skyrimax/Autobar/Document Remise/Rapport final/Image/Distributeur_Beaumont.jpg

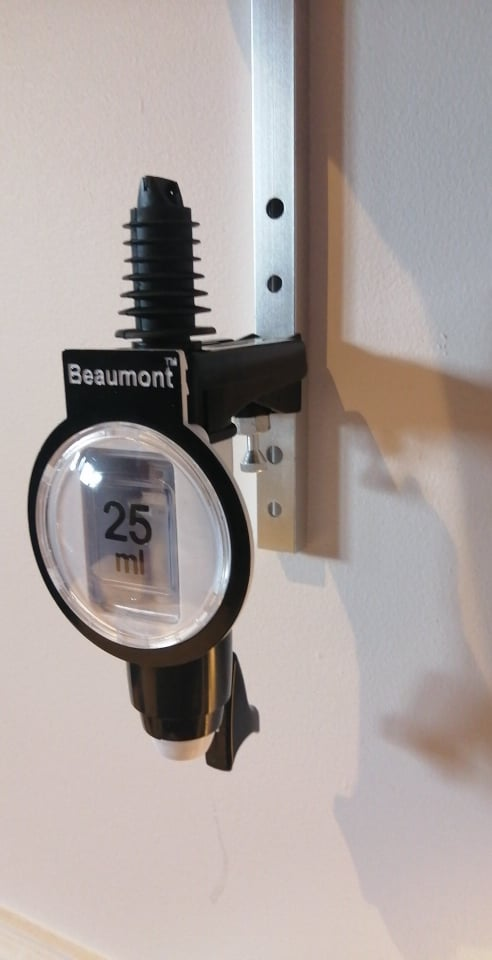
Document Remise/Rapport final/Image/Distributeur_Beaumont.jpg
