skyrimax/Autobar/Document Remise/Rapport etape/Axe_lineaire_seul_Nema17.JPG

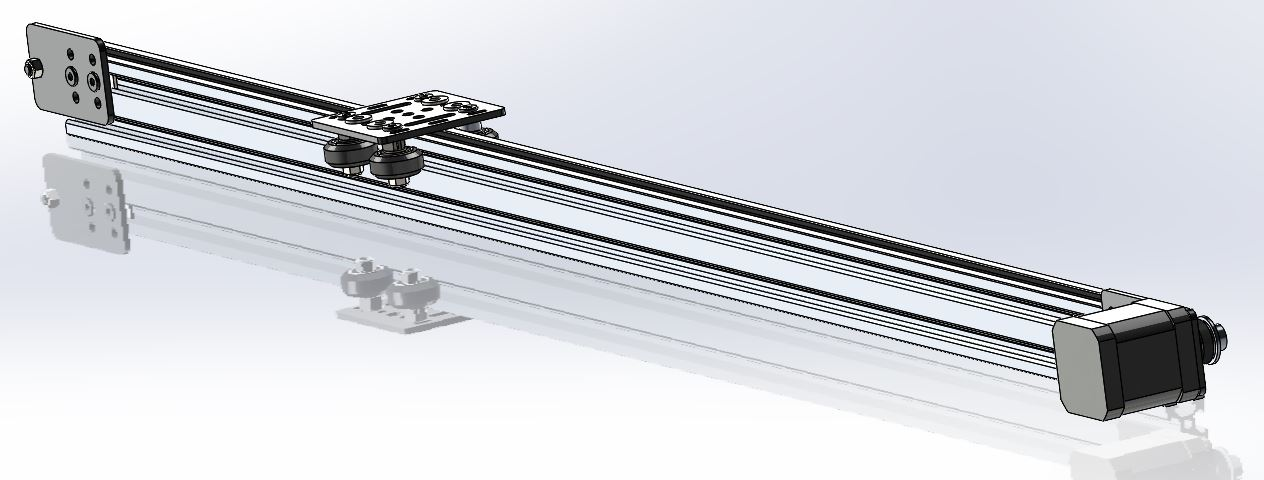
Document Remise/Rapport etape/Axe_lineaire_seul_Nema17.JPG
