skyrimax/Autobar/Choix de concept/Définition besoin.docx

Choix de microcontrôleur (électronique logique)

https://all3dp.com/fr/1/single-board-computer-raspberry-pi-alternative/

CanOpen, i2c, pwm, in/out, internet, écran tactile?

- Internet (wifi)
- 1 moteur encodeur (robotshop) avec drive (can, i2c, pwm) versaplanetary
- LED
- Écran tactile
- Actuateur (activation distributeur)
