skyrimax/Autobar/Document Remise/Rapport etape/Matrice_Final.pdf

Esthétique | Coût | Simplicité conception | Aisance de maintenance | Expérience utilisateur | Fonctionnalités | Total
Concept | 14% | 10% | 24% | 18% | 20% | 14% | 100%
1 | 70% | 90% | 90% | 90% | 30% | 60% | 71%
2 | 80% | 85% | 90% | 85% | 35% | 60% | 72%
3 | 85% | 70% | 80% | 70% | 70% | 80% | 76%
4 | 80% | 50% | 65% | 60% | 70% | 85% | 69%
5 | 60% | 65% | 80% | 80% | 30% | 65% | 63%
6 | 90% | 40% | 60% | 55% | 90% | 70% | 69%

# Matrice de décision finale
