skyrimax/Autobar/Document Remise/Affiche/Affiche.pdf

## AutoBar : Système automatisé de distribution de boisson alcoolisée

Inconvénients :
- Limité pour le nombre de bouteilles
- Exécution d’une commande à la fois
- Difficilement modulable

Avantages :
- L’interface utilisateur améliore l’expérience client
- Base de données assure la cohérence des données
- Réduction du nombre d’équipements à contrôler

## 3. Avantages/Inconvénients

Inconvénients :
- Limité pour le nombre de bouteilles
- Exécution d’une commande à la fois
- Difficilement modulable

Avantages :
- L’interface utilisateur améliore l’expérience client
- Base de données assure la cohérence des données
- Réduction du nombre d’équipements à contrôler

## 3. Avantages/Inconvénients

Inconvénients :
- Limité pour le nombre de bouteilles
- Exécution d’une commande à la fois
- Difficilement modulable

Avantages :
- L’interface utilisateur améliore l’expérience client
- Base de données assure la cohérence des données
- Réduction du nombre d’équipements à contrôler

## 3. Avantages/Inconvénients

Présenté par : Hugo Beaulieu Blanchette, Frédéric Grondines, Jean-Philippe Lozeau et Maxime Royal

Il s’agit d’automatiser un service de distribution de boisson alcoolisée et non-alcoolisée pour une utilisation personnelle ou lors de petits évènements.

Objectifs :
- Simplicité de conception
- Expérience utilisateur mise de l’avant
- Interface utilisateur
- Historique des données

## 1. Problématique

Il s’agit d’automatiser un service de distribution de boisson alcoolisée et non-alcoolisée pour une utilisation personnelle ou lors de petits évènements.

Objectifs :
- Simplicité de conception
- Expérience utilisateur mise de l’avant
- Interface utilisateur
- Historique des données

## 1. Problématique

Il s’agit d’automatiser un service de distribution de boisson alcoolisée et non-alcoolisée pour une utilisation personnelle ou lors de petits évènements.

Objectifs :
- Simplicité de conception
- Expérience utilisateur mise de l’avant
- Interface utilisateur
- Historique des données
1. | Problématique | 18

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

Objectifs :
- Simplicité de conception
- Expérience utilisateur mise de l’avant
- Interface utilisateur
- Historique des données
1. | Problématique | 18 | 2. | Solution

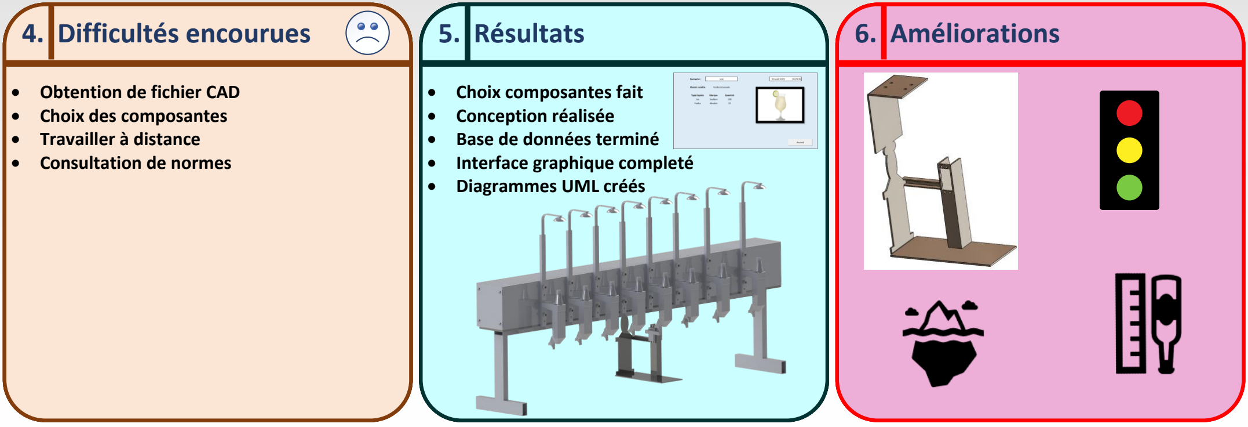
[picture p25: figure]
6. Améliorations; • Choix composantes fait • Conception réalisée • Base de données terminé • Interface graphique completé • Diagrammes UML créés; 5. Résultats; • Obtention de fichier CAD • Choix des composantes • Travailler à distance • Consultation de normes; 4. Difficultés encourues
