skyrimax/Autobar/Document Remise/Affiche/Affiche_Example.pdf

`

# Aero-Planning : outil de gestion de maintenance d’une flotte d’aéronefs

Projet de fin d’études présenté par | , finissante en génie

# Abstrait

- Inspection régulière
- Défaillance
- AD / SB

# Problématique

- Les écoles de pilotage
possèdent beaucoup d’appareils nécessitant un suivi rigoureux
- Liste d’un bon nombre d’items à surveiller
- Actuellement : utilisation d’une liste Excel
- Pas de traçabilité des mises à jour
- Beaucoup d’impression inutile
- Difficilement accessible (un seul à la fois)

# Solution

Les objectifs de ce projet sont de :
- Gérer la cédule de maintenance et les éléments d’entretien des aéronefs ;
- Effectuer le suivi des heures d’opération ;
- Produire des rapports facilitant des audits avec Transport Canada et indiquant les prochaines tâches à suivre sur la flotte.

# Méthodes de travail

# Problèmes encourus

- Disponibilité du programmeur
- Disponibilité du client
- Gestion du temps

# Résultats

# Conclusions

- Le client voulait un outil pour effectuer le suivi des heures d’opération de chaque appareil : un outil flexible, visuel, accessible et facile à utiliser
- Le travail en PME est différent du travail en grande entreprise
- L’outil est encore à la phase de tests et bientôt prêt à être dévoilé au client
- Notre objectif futur est de déployer l’outil chez d’autres exploitants d’aéronefs au Québec

États

Tout est beau

Actions dans les
tolérances

Actions requises
immédiatement

Aéronef

Cédule de
maintenance

Heures d’opération

- En aéronautique, il est
essentiel de garder une
traçabilité sur tout
- Il s’agit d’un domaine stricte et très réglementé, axé sur la sécurité
Web | iPhone | Backup | Plusieurs utilisateurs
Besoins
du client
- Moteur(s)
- Instruments
- Fuselage
- Hélice(s)
- Gouvernes
- Autres items

Outils informatique

Serveur web

Base de données

Savoir pratique

Réglementation
de l’aviation
canadien

Grille de
maintenance

Gestion de projet

Discussion
intantanée

Assignation et
suivi des tâches

Framework

Language de
programmation

Contrôle de
version

Système
d’exploitation

Méthodologie scrum

Méthodologie agile

Prototype

- Confidentialité du client
- Réglementation complexe
à ne pas négliger
