skyrimax/Autobar/Document Remise/machine_rendu.JPG

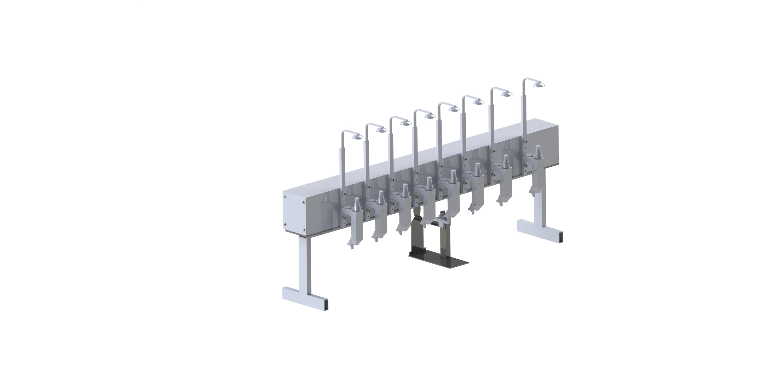
Document Remise/machine_rendu.JPG
