skyrimax/Autobar/Document Remise/Rapport etape/Axe_lineaire_ass.JPG

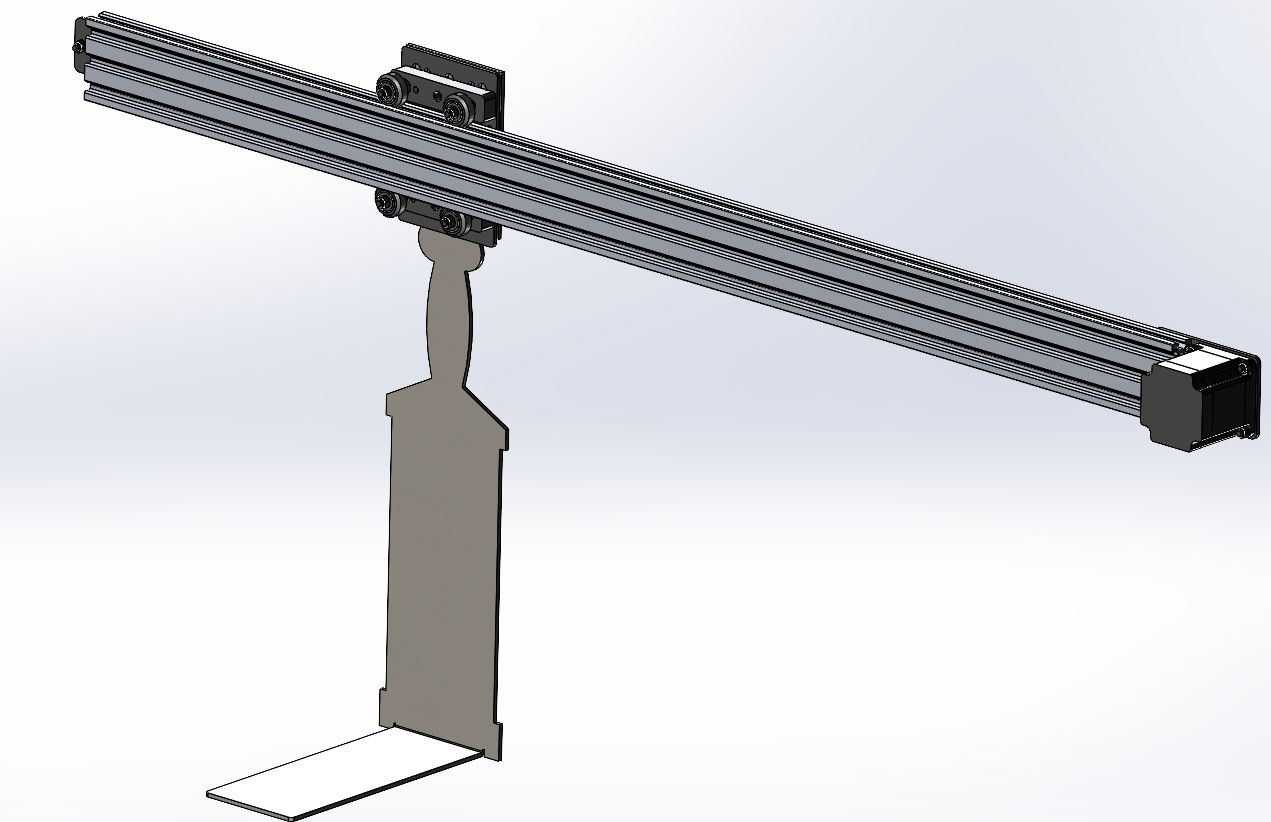
Document Remise/Rapport etape/Axe_lineaire_ass.JPG
