skyrimax/Autobar/Document Remise/Rapport etape/Axe_lineaire_seul.JPG

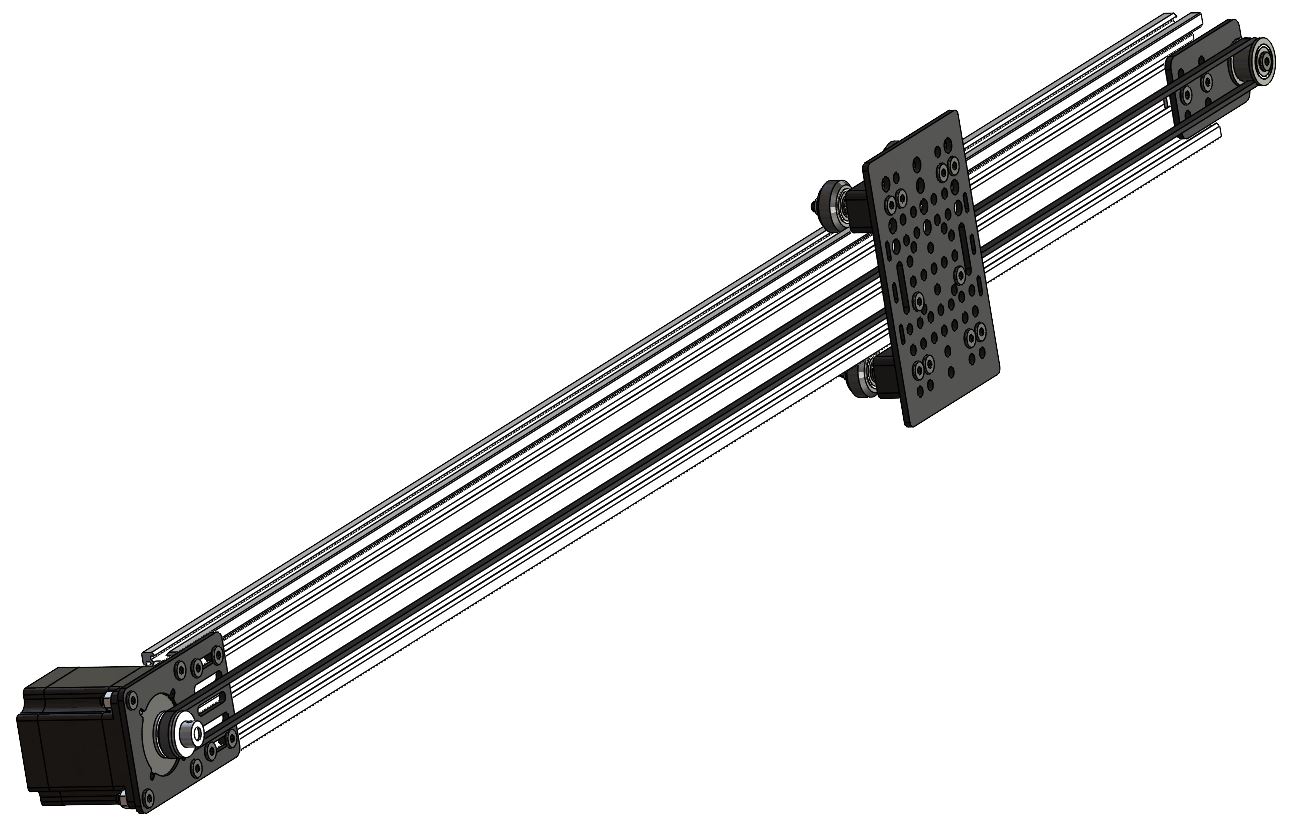
Document Remise/Rapport etape/Axe_lineaire_seul.JPG
