skyrimax/Autobar/Document Remise/Rendu_Machine.png

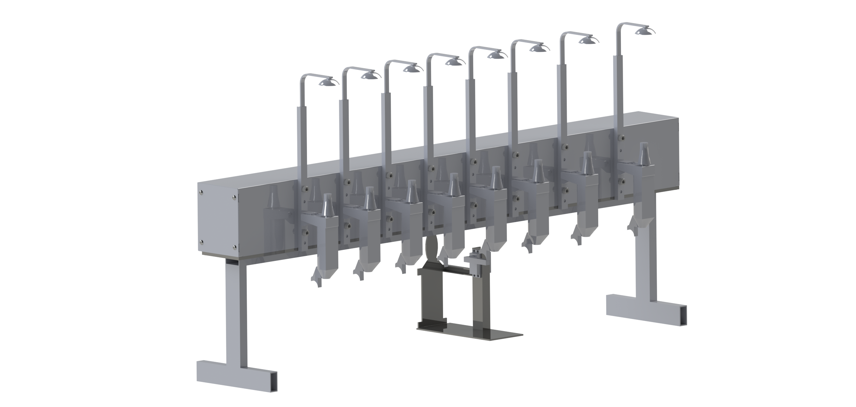
Document Remise/Rendu_Machine.png
