skyrimax/Autobar/Choix de concept/Différents choix.xlsx

Sheet: Association
 |  | Association des différents mécanismes
Impossible | Difficile | Contenant pour distribution |  |  | Disposition bouteille |  |  | Mécanisme de distribution |  |  | Mécanisme de mouvement |  |  | Récipient liquide |  |  |  | Lecture du volume
Faisable | Bon | Bouteille d'origine | Contenant sur mesure | Mixte | En ligne | En cercle | En étage? | Pompe péristaltique | Connecteur universel | Connecteur magnétique | Fixe | Convoyeur | Bouteille en mouvement | Verre plastique standard | Verre custom | Verre spécialisée | Contenant fixe | Lecteur de pression | Mécanisme présent | Capteur numérique | Flotteur | Capteur capacitif
Contenant pour distribution | Bouteille d'origine
 | Contenant sur mesure
 | Mixte
Disposition bouteille | En ligne
 | En cercle
 | En étage?
Mécanisme de distribution | Pompe péristaltique
 | Connecteur universel
 | Connecteur magnétique
Mécanisme de mouvement | Fixe
 | Convoyeur
 | Bouteille en mouvement
Récipient liquide | Verre plastique standard
 | Verre custom
 | Verre spécialisée
 | Contenant fixe
Lecture du volume | Lecteur de pression
 | Mécanisme présent
 | Capteur numérique
 | Flotteur
 | Capteur capacitif

Sheet: Matrice de décision partiel
 |  |  | Matrice de décision partielle
 |  |  | Esthétique | Coût | Simplicité | Fonctionnalité | Synergie | Total | Total avec poids
 | Poids (%) |  | 10% | 15% | 30% | 25% | 20% | 100%
Contenant pour distribution | 15% | Bouteille d'origine | 100% | 100% | 85% | 90% | 65% | 86.0% | 12.9%
 |  | Contenant sur mesure | 50% | 60% | 60% | 70% | 85% | 66.5% | 10.0%
 |  | Mixte | 75% | 70% | 50% | 65% | 70% | 63.2% | 9.5%
Disposition bouteille | 15% | En ligne | 70% | 100% | 90% | 80% | 90% | 87.0% | 13.1%
 |  | En cercle | 95% | 80% | 75% | 60% | 80% | 75.0% | 11.2%
 |  | En étage? |  |  |  |  |  | 0.0% | 0.0%
Mécanisme de distribution | 25% | Pompe péristaltique | 60% | 70% | 85% | 90% | 75% | 79.5% | 19.9%
 |  | Connecteur universel | 90% | 100% | 95% | 75% | 65% | 84.2% | 21.1%
 |  | Connecteur magnétique | 70% | 20% | 10% | 95% | 35% | 43.8% | 10.9%
Mécanisme de mouvement | 30% | Fixe | 30% | 100% | 100% | 40% | 90% | 76.0% | 22.8%
 |  | Convoyeur | 70% | 85% | 85% | 80% | 80% | 81.3% | 24.4%
 |  | Bouteille en mouvement | 90% | 70% | 65% | 85% | 65% | 73.2% | 22.0%
Récipient liquide | 10% | Verre plastique standard | 20% | 100% | 90% | 60% | 80% | 75.0% | 7.5%
 |  | Verre custom | 50% | 60% | 80% | 70% | 100% | 75.5% | 7.5%
 |  | Verre spécialisée | 100% | 20% | 40% | 60% | 70% | 54.0% | 5.4%
 |  | Contenant fixe | 40% | 80% | 70% | 80% | 100% | 77.0% | 7.7%
Lecture du volume | 5% | Lecteur de pression | 50% | 60% | 60% | 40% | 60% | 54.0% | 2.7%
 |  | Mécanisme présent | 100% | 100% | 100% | 70% | 95% | 91.5% | 4.6%
 |  | Capteur numérique | 85% | 50% | 40% | 80% | 65% | 61.0% | 3.1%
 |  | Flotteur | 60% | 90% | 70% | 70% | 70% | 72.0% | 3.6%
 |  | Capteur capacitif | 90% | 60% | 50% | 85% | 40% | 62.3% | 3.1%
Total | 100%

Sheet: Concepts
 |  | Concepts
 |  | Concept #1 | Concept #2 | Concept #3 | Concept #4 | Concept #5 | Concept #6
Contenant pour distribution | Bouteille d'origine | x | x | x |  |  | x
 | Contenant sur mesure |  |  |  | x | x
 | Mixte
Disposition bouteille | En ligne | x |  | x | x | x
 | En cercle |  | x |  |  |  | x
 | En étage?
Mécanisme de distribution | Pompe péristaltique |  |  |  | x
 | Connecteur universel | x | x | x |  | x | x
 | Connecteur magnétique
Mécanisme de mouvement | Fixe | x | x |  |  | x
 | Convoyeur |  |  | x | x
 | Bouteille en mouvement |  |  |  |  |  | x
Récipient liquide | Verre plastique standard | x | x | x |  | x | x
 | Verre custom | x | x | x |  |  | x
 | Verre spécialisée | x | x | x |  |  | x
 | Contenant fixe | x | x | x | x
Lecture du volume | Lecteur de pression
 | Mécanisme présent | x | x | x | x |  | x
 | Capteur numérique
 | Flotteur |  |  |  |  | x
 | Capteur capacitif

Sheet: Matrice de décision concept
 | Matrice de décision finale
 | Esthétique | Coût | Simplicité conception | Aisance de maintenance | Expérience utilisateur | Fonctionnalités | Total
Concept | 14.28571429% | 9.523809524% | 23.80952381% | 17.85714286% | 20.23809524% | 14.28571429% | 100%
1 | 70% | 90% | 90% | 90% | 30% | 60% | 70.71428571%
2 | 80% | 85% | 90% | 85% | 35% | 60% | 71.78571429%
3 | 85% | 70% | 80% | 70% | 70% | 80% | 75.95238095%
4 | 80% | 50% | 65% | 60% | 70% | 85% | 68.69047619%
5 | 60% | 65% | 80% | 80% | 30% | 65% | 63.45238095%
6 | 90% | 40% | 60% | 55% | 90% | 70% | 68.98809524%
J-p | 4 | 1 | 5 | 3 | 6 | 2
max | 3 | 2 | 4 | 5 | 6 | 1
fred | 3 | 4 | 6 | 1 | 2 | 5
hugo | 2 | 1 | 5 | 6 | 3 | 4
Moyenne | 3 | 2 | 5 | 3.75 | 4.25 | 3
 | 14.28571429% | 9.523809524% | 23.80952381% | 17.85714286% | 20.23809524% | 14.28571429%
 |  |  |  |  | UI intuitif

Sheet: Carte ordinateur
Carte | Processeur/ microcontrôleur | Horloge | Mémoire | Power supply | Connectivité | PIN | Vidéo | Ports | CanOpen | Langage programmation | Prix
Raspberry PI 4B | ARM v8 | 1,5 GHz | 2 Go, 4 Go, 8 Go | 5.1 V, 3 A | Gigabit ethernet, wifi intégré, bluetooth | 40 pin GPIO, 4 PWM, SPI, I2C, Serial | 2 ports micro HDMI 4K | 2 ports USB 2, 2 ports USB 3 | Extension possible | C, C++, Python… | 85$ - 135$ (Amazon)
Raspberry PI Zero W | ARM11 | 1 GHz | 512 Mo | 5.1 V, 1.2 A | Wifi, bluetooth | 40 pin GPIO, 4 PWM, SPI, I2C, Serial | 1 port mini HDMI | 2 ports micro-USB | Extension possible | C, C++, Python… | 34$ - 43$ (Amazon)
Arduino Uno R3 | ATmega328P | 16 MHz | FLASH 32 KB, SRAM 2 KB, EEPROM 1KB | 7 - 12 V, 2 A | Module d'extension wifi et bluetooth possible | 14 pins I/O digital, 6 PWM, 6 entrées analogues | Non intégré | 1 port USB | Extension possible | C, C++ | 17$ - 23$ (Amazon)
Arduino Uno Wifi R2 | ATmega4809 | 16 MHz | FLASH 48 Bytes, SRAM 6 144 Bytes, EEPROM 256 Bytes | 7 - 12 V, 2 A | Wifi intégré, module bluetooth possible | 14 pins I/O digital, 5 PWM, 6 entrées analogues | Non intégré | 1 port USB | Extension possible | C, C++ | 45$ (store.arduino.cc)
PocketBeagle | Cortex-A8 | 1 GHz | 512 Mo | 5 V, 2 A | Module d'extension wifi et bluetooth possible | 44 pins GPIO, I2C, SPI, 4 PWM, 8 entrées analogiques | Non intégré | 1 port micro-USB | 2 ports | Linux | 46$ (digikey.ca) 42$ (canada.newark.com)
Onion Omega2+ | MIPS | 580 MHz | 128 Mo | 3.3 V, 0.5A | Wired ethernet, wifi intégré, module bluetooth possible | 18 pins GPIO, 2 PWM, I2C, SPI | Extension noir et blanc possible | 1 port USB | Non intégré | C, C++, Python…. | 35$ (mouser.ca)

Sheet: Axe linéaire
 | Actuateur | Moteur | Bras de soutient
Nom | V-Slot linear Bundle | Nema 17 stepper motor
Image
Description |  | Step moteur qui va controler le déplacement de la glissière sur le rail
Lien
 |  | Driver A4988 (https://www.pololu.com/product/1182)

Sheet: Écran HMI
Modèle/fabricant | Dimension | Résolution | Prix | Spécification
Sunfounder LCD Capacitive Touchscreen | 7 " | 1024 X 600 | 76,91 $ (Robotshop) | Inclus un cable HDMI à micro HDMI Possède les trous et vis pour installation
TeNizo Écran tactile capacitif | 7 " | 1024 X 600 (1920 X 1080) | 89,97 $ (Amazon) | Inclus un adapteur HDMI à micro HDMI Vient avec un étui de montage
Capacitive touch screen | 7 " | 1024 X 600 (1920 X 1080) | 84,60 $ (Robotshop) | Possède une entrée audio et connexion de speaker

Sheet: Consommation électrique
Composantes | 5V |  | 12V
 | Courant max | Puissance max | Courant max | Puissance max
Contrôleur | 2 | 10
Moteur Nema-17 |  |  | 3.36 | 40.32
Servo moteur | 4.2 | 21
Ventilateur |  |  | 0.07 | 0.84
Écran tactile |  |  | 2 | 24
Total | 6.2 | 31 | 5.43 | 65.16

Sheet: Finance
Sections | Composantes |  | Coûts |  |  |  |  | Proportion
 | Nom | Description/Numéro/Modèle | Quantité |  | Prix |  | Prix total | Sectoriel | Total
Base | Support principal | Tube acier 1020 1-1/2" X 3/4" X 0,08" | 75 | po | 0.40 $ | /po | 30.00 $ | 26.1% | 2.7%
 | Recouvrement | feuille Aluminium 1/32 épais | 735 | po^2 | 0.03 $ | /po^2 | 22.79 $ | 19.9% | 2.1%
 | Pièces de support | Plaque acier 1020 4" X 1/4" ép. | 50 | po | 0.64 $ | /po | 32.00 $ | 27.9% | 2.9%
 | Support boîtié électrique | Duramex 80-064 | 1 |  | 30.00 $ |  | 30.00 $ | 26.1% | 2.7%
 |  |  |  |  |  |  | 0.00 $ | 0.0% | 0.0%
 |  |  |  |  |  |  | 114.78 $ | 100.0% | 10.4%
Mécanisme de distribution | Axe linéaire | V-Slot Belt Driven Actuator | 1 |  | 130.00 $ |  | 130.00 $ | 35.1% | 11.8%
 | Moteur pas-à-pas | Nema 17 Stepper motor | 1 |  | 20.00 $ |  | 20.00 $ | 5.4% | 1.8%
 | Support verre | Plaque d'acier AISI 304 23" X 4" X 1/8" | 1 |  | 44.00 $ |  | 44.00 $ | 11.9% | 4.0%
 | Support bouteille | Plaque d'acier | 8 |  | 6.00 $ |  | 48.00 $ | 13.0% | 4.4%
 | Servo moteur | DS3218MG | 1 |  | 10.00 $ |  | 10.00 $ | 2.7% | 0.9%
 | Capteurs fin de course | D2HW-BR221M | 2 |  | 15.00 $ |  | 30.00 $ | 8.1% | 2.7%
 | Distributeur de liquide | Distributeur beaumont | 8 |  | 11.00 $ |  | 88.00 $ | 23.8% | 8.0%
 |  |  |  |  |  |  | 0.00 $ | 0.0% | 0.0%
 |  |  |  |  |  |  | 370.00 $ | 100.0% | 33.6%
Éléments électriques/ électroniques | Micro ordinateur | Raspberry Pi Modèle 4B | 1 |  | 54.00 $ |  | 54.00 $ | 13.0% | 4.9%
 | Contrôleur du moteur | Allegro A4988 | 1 |  | 8.00 $ |  | 8.00 $ | 1.9% | 0.7%
 | Relais | Module à double relais Phidgets | 1 |  | 22.00 $ |  | 22.00 $ | 5.3% | 2.0%
 | Alimentation électrique | RD-125A | 1 |  | 33.00 $ |  | 33.00 $ | 7.9% | 3.0%
 | Bouton sécurité | MCC2E-BVE20R | 1 |  | 12.00 $ |  | 12.00 $ | 2.9% | 1.1%
 | Interrupteur principal | A8GS-P1310 | 1 |  | 15.00 $ |  | 15.00 $ | 3.6% | 1.4%
 | Boîte électrique | CHKO12126 | 1 |  | 50.00 $ |  | 50.00 $ | 12.0% | 4.5%
 | Écran tactil | Écran 10,1 " Sunfunder | 1 |  | 200.00 $ |  | 200.00 $ | 48.1% | 18.2%
 | Ventilateur | NF-A9 FLX | 1 |  | 22.00 $ |  | 22.00 $ | 5.3% | 2.0%
 |  |  |  |  |  |  | 0.00 $ | 0.0% | 0.0%
 |  |  |  |  |  |  | 416.00 $ | 100.0% | 37.8%
Autres | Quaincaillerie |  | 1 |  | 100.00 $ |  | 100.00 $ | 50.0% | 9.1%
 | Composantes autres |  | 1 |  | 100.00 $ |  | 100.00 $ | 50.0% | 9.1%
 |  |  |  |  |  |  | 0.00 $ | 0.0% | 0.0%
 |  |  |  |  |  |  | 200.00 $ | 100.0% | 18.2%
Total |  |  |  |  |  |  | 1100.78 $ |  | 100.0%
 |  |  |  |  | Bénéfice |  | 50%
 |  |  |  |  |  |  | 550.39 $
 |  |  |  |  | Prix de vente |  | 1651.18 $
 |  |  |  |  | Alkobot |  | 1760.00 $
 |  |  |  |  | Bénéfice |  | 59.88589961%
