skyrimax/Autobar/Conception/Interface Utilisateur/UI.xlsm

Sheet: Log In
 |  | 2021-08-10 | 10:31:44
Nom d'utilisateur : | Loki
Mot de passe : | **********

Sheet: Page accueil
Connecté : | Loki |  | 2021-08-10 | 10:31:44
 |  |  | Bouteilles diponibles
 |  | 1- | Coke
 |  | 2- | Sprite
Commande en cours : |  | 3- | Limonade
Commande #127 |  | 4- | Jus d'orange
 |  | 5- | Rhum blanc Bacardi
 |  | 6- | Tequila 1800 Silver
 |  | 7- | Vodka Absolut
 |  | 8- | Gin Gordon's
 |  | 9- | Jack Daniel Whisky

Sheet: Création compte client
 |  | 2021-08-10 | 10:31:44
Nom utilisateur | Loki
Nom | De Asgard
Prénom | Loki
Age | 95
Mot de passe | Tesseract
Courriel | lokiLUVsylvie@asgard.net

Sheet: Compte client
 | Connecté : | Loki |  | 2021-08-10 | 10:31:44
 | Création de recette |  |  | 3 recettes favoris
- | Bloody Shunshine |  | #1 | Rhum and Coke
- | The Robot |  | #2 | Tequila
- | SpaceY |  | #3 | Vodka Limonade

Sheet: Création recette
Connecté : | Loki |  |  | 2021-08-10 | 10:31:44
Nom de la recette : |  | SpaceY
 | Type liquide | Marque | Quantité
#1 | Jus | Sealtest | 200
#2 | Téquila | 1800 Silver | 25
#3 | Vodka | Absolut | 25
#4

Sheet: Commandez
Connecté : | Loki |  |  | 2021-08-10 | 10:31:44
Boisson |  | Prix | Ratio alcool
Rhum and Coke |  | $2.50 | 0.0
Vodka Limonade |  | $4.50 | 2.0
Limonade |  | $2.50 | 0.0
Tequila |  | $3.00 | 1.5
 | Total : | $12.50

Sheet: Évaluation
Connecté : | Loki |  | 2021-08-10 | 10:31:44
Évalution de recette
Rhum and Coke |  | 4
Vodka Limonade |  | 3
Tequila |  | 2
Limonade |  | 5

Sheet: Menu recette
Connecté : | Loki |  | 2021-08-10 | 10:31:44
Choisir recette | Coke
Type liquide | Marque | Quantité
Jus | Sealtest | 200
Vodka | Absolut | 25

Sheet: Gestion machine
Responsable : | Charles Patenaud | 2021-08-10 | 10:31:44
Niveau des bouteilles :

Sheet: Configuration
Responsable : |  | Jessica Dufour | 2021-08-10 | 10:31:44
Parametres WIFI :
 | Réseau :
 | Mot de passe :

Sheet: Bouteille
 |  | 2021-08-10 | 10:31:44
Volume initial : | 1120
Volume actuel : | 56
Type : | Vodka
Marque : | Absolut
Emplacement : | 7

Sheet: Changement Bouteille
 |  | 2021-08-10 | 10:31:44
Volume initial : |  | Volume initial :
Type : |  | Type :
Marque : |  | Marque :
Emplacement : | 7 | Emplacement :

Sheet: Création compte employee
 |  | 2021-08-10 | 10:31:44
Nom utilisateur | employes2
Nom | Tremblay
Prénom | Charles
Age | 28
Mot de passe | password
Courriel | charles.tremblay@abc.com
# Téléphonne | 514-123-4567
Salaire | $23.00

Sheet: Alarmes
 |  |  |  |  | 2021-08-10 | 10:31:44
Heure alarme | Niveau | Descritpion | Ack | Clear | Heure Clear
2021-06-25 | 1 | Niveau bouteille 6 bas | True | False
2021-06-25 | 1 | Niveau bouteille 7 bas | True | Flase
Filtre :

Sheet: Maintenance
 |  |  |  | 2021-08-10 | 10:31:44
Date début | Description | Date de fin | Employé
2021-05-15 | Calibration glissière | 2021-05-16 | Charles Patenaud
Descritpion :
