skyrimax/Autobar/Conception/Interface Utilisateur/UI.xlsx

Sheet: Log In
 |  | 2021-08-03 | 18:30:13
Nom d'utilisateur : | Loki
Mot de passe : | **********

Sheet: Création compte client
 |  | 2021-08-03 | 18:30:13
Nom utilisateur | Loki
Nom | De Asgard
Prénom | Loki
Age | 95
Mot de passe | Tesseract
Courriel | lokiLUVsylvie@asgard.net

Sheet: Compte client
Logged as : | Loki | 2021-08-03 | 18:30:13

Sheet: Page accueil
Logged as : | Loki | 2021-08-03 | 18:30:13

Sheet: Ajout mode paiement
Logged as : | Loki | 2021-08-03 | 18:30:13
# Carte | 1234 5678 1234 5678
Code sécurité | 123
Date expiration | 0312
Adresse | 2139 Avenue de la Salle, Montréal, Canada, H1V 2K7

Sheet: Commandez
Logged as : | Loki | 2021-08-03 | 18:30:13

Sheet: Choisir recette
Logged as : | Loki | 2021-08-03 | 18:30:13

Sheet: Gestion machine
2021-08-03 | 18:30:13

Sheet: Création compte employee
 |  | 2021-08-03 | 18:30:13
Nom utilisateur | employes2
Nom | Tremblay
Prénom | Charles
Age | 28
Mot de passe | password
Courriel | charles.tremblay@abc.com
# Téléphonne | 514-123-4567
Salaire | $23.00

Sheet: Alarmes
 |  |  |  |  | 2021-08-03 | 18:30:13
Heure alarme | Système | Descritpion | Clear | Ack | Heure Clear
Filtre :

Sheet: Maintenance
 |  |  |  | 2021-08-03 | 18:30:13
Date début | Description | Date de fin | Employé
