skyrimax/Autobar/Conception/Actionneur à bouteilles/Assemblage Servo-moteur.SLDASM

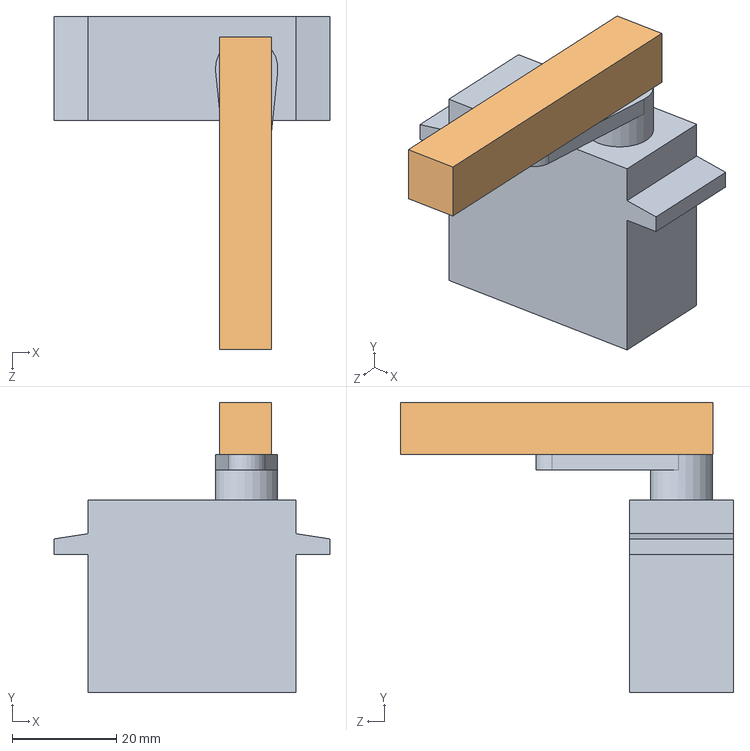
[picture p30: CAD file, 2021-08-18]
Conception/Actionneur à bouteilles/Assemblage Servo-moteur.SLDASM
53.0 x 55.7 x 64.0 mm
Servo Moteur
Bras actionneur
