skyrimax/Autobar/Conception/Assemblage Interface Utilisateur/Assemblage Interface Utilisateur.SLDASM

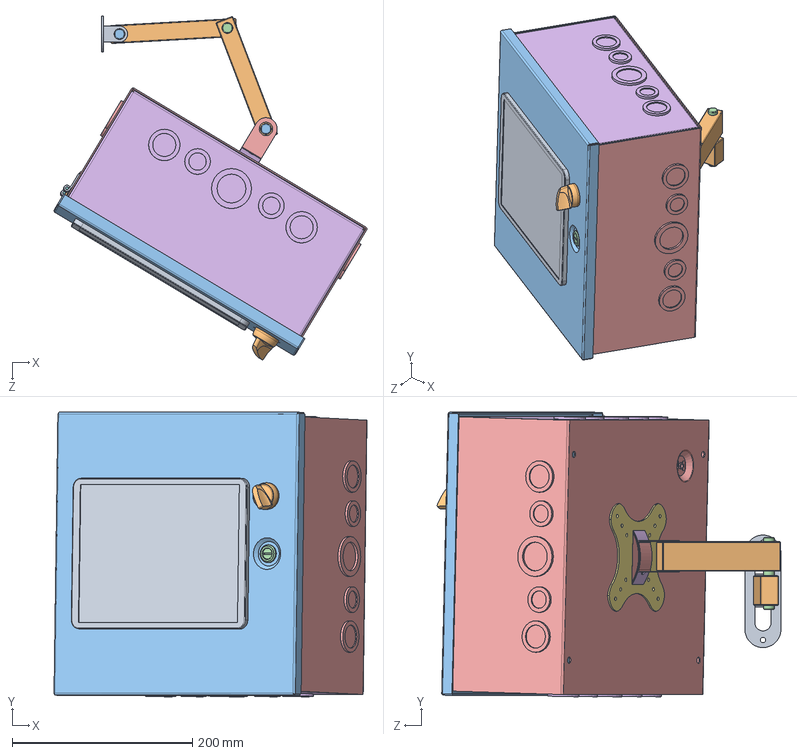
[picture p31: CAD file, 2021-08-18]
Conception/Assemblage Interface Utilisateur/Assemblage Interface Utilisateur.SLDASM
347.6 x 316.1 x 382.0 mm
LCD Mount - Base
LCD Mount - Handle x 2
LCD Mount - Rod x 2
LCD Mount - Rod No.2
LCD Mount - U Bracket
LCD Mount - U Bracket(Complementary)
LCD Mount - Display Hanger
HNG11000-3.stp x 2
HNG11000-2.stp x 2
HNG11000-0.stp x 2
COM56469.stp
LOC13368.stp
Com55565-5.stp
COM55087-4.stp x 2
QLB20292.stp
SCS19515.stp
Ecran
8382K66_Metal 22mm Panel-Mount Lever Switch
