skyrimax/Autobar/Conception/Axe lineaire/Axe_1000mm_Nema17/Solid V Wheel.SLDASM

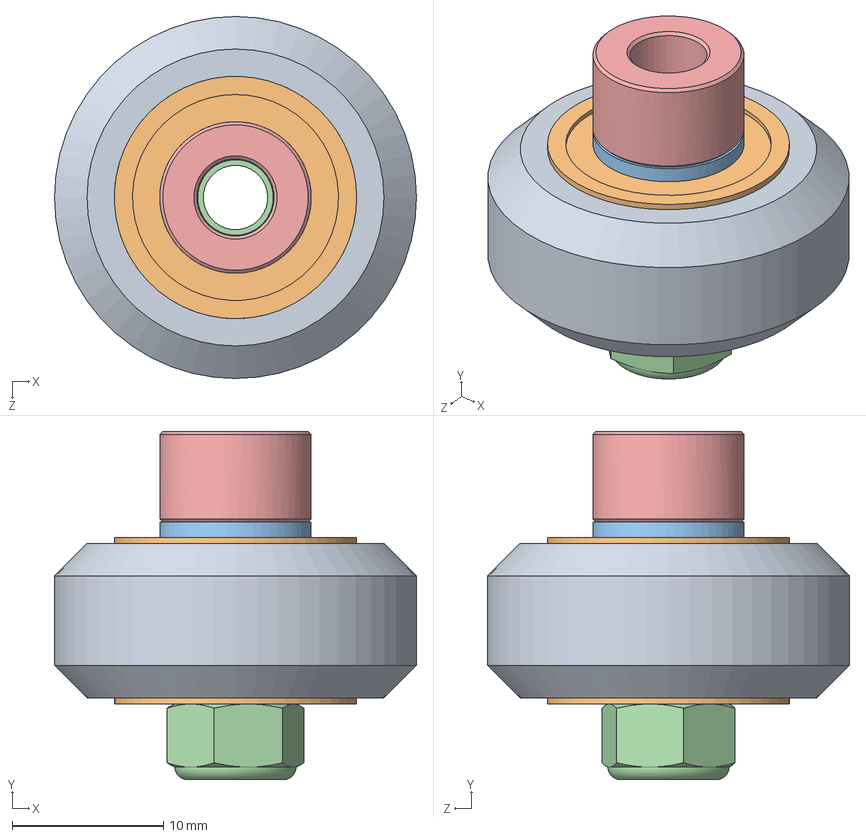
[picture p32: CAD file, 2021-08-18]
Conception/Axe lineaire/Axe_1000mm_Nema17/Solid V Wheel.SLDASM
23.9 x 23.0 x 23.9 mm
Solid V Wheel
Ball Bearing 5 x 16 x 5 x 2
Precision Shim 10 x 5 x 1 x 2
Nylon Insert Lock Nut M5
Aluminum Spacer 6mm
