skyrimax/Autobar/Conception/Base/Base.SLDASM

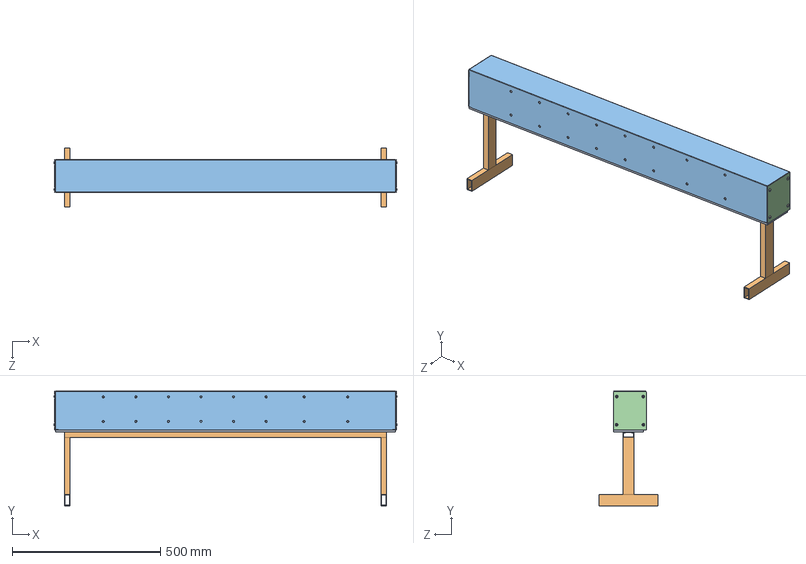
[picture p33: CAD file, 2021-08-18]
Conception/Base/Base.SLDASM
1158.6 x 387.1 x 200.0 mm
poutre principale
pattes
Cloison
Couvert cloison x 2
socket head cap screw_am x 12
95105A175_ZINC-PLATED STEEL HEAVY-DUTY RIVET NUT x 8
socket button head cap screw_am x 8
