skyrimax/Autobar/Conception/Fit bouteilles/Fit bouteilles.SLDASM

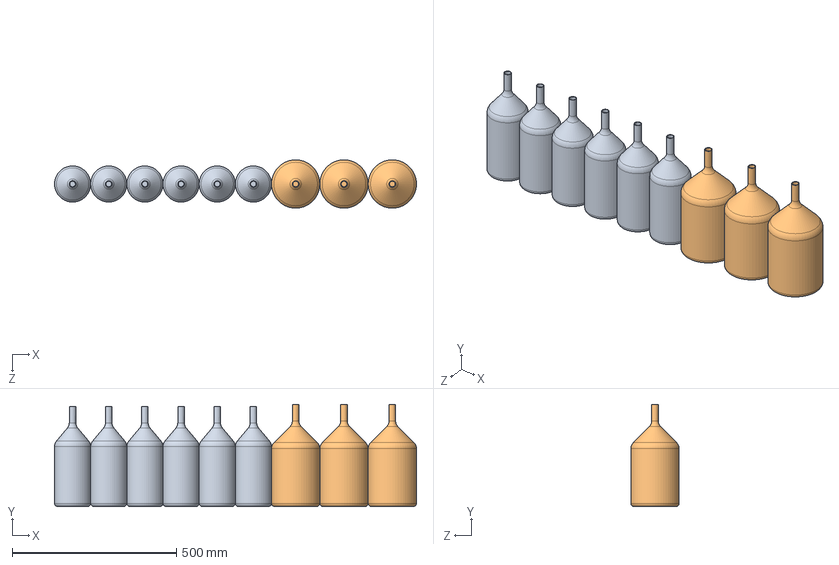
[picture p34: CAD file, 2021-08-18]
Conception/Fit bouteilles/Fit bouteilles.SLDASM
1101.0 x 310.8 x 147.0 mm
bouteille 110 mm x 6
bouteille 147 mm x 3
