skyrimax/Autobar/Conception/Machine.SLDASM

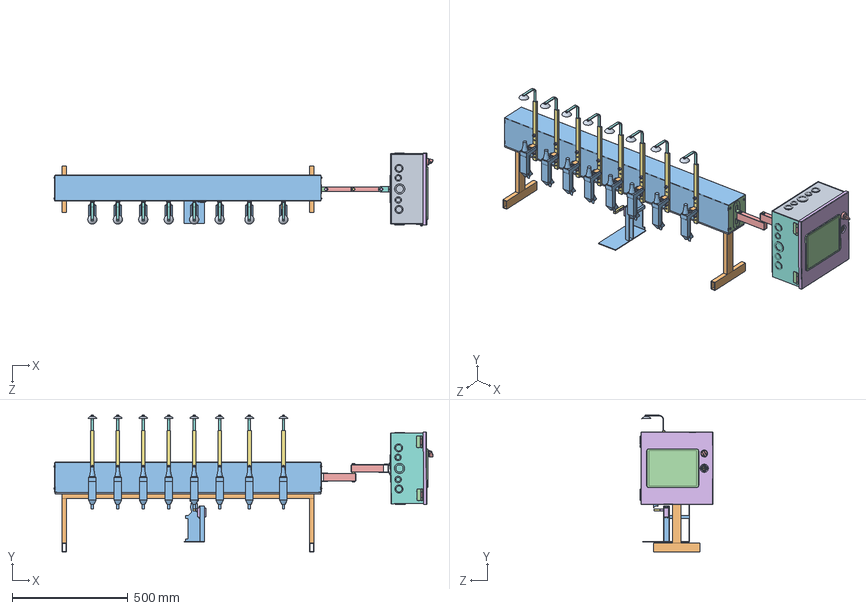
[picture p35: CAD file, 2021-08-18]
Conception/Machine.SLDASM
1637.5 x 590.0 x 316.0 mm
poutre principale
pattes
Cloison
Couvert cloison x 2
socket head cap screw_am x 16
95105A175_ZINC-PLATED STEEL HEAVY-DUTY RIVET NUT x 8
socket button head cap screw_am x 8
Double Tee Nut x 2
Low Profile Screw M5 x 9
Button Head Socket Cap Screw M3 x 4
Nylon Insert Lock Nut M5 x 5
V-Slot 20x40x1000 Linear Rail
Motor Mount Plate Nema 17
Idler Pulley Plate
Nema 17 Stepper Motor
GT2 Timing Pulley 30 Tooth
Smooth Idler Pulley Wheel
Ball Bearing 5 x 16 x 5 x 10
Nylon Spacer 0.125in
Aluminum Spacer 3mm
V-Slot Gantry Plate 20mm
Solid V Wheel x 4
Precision Shim 10 x 5 x 1 x 8
Aluminum Spacer 6mm x 2
Eccentric Spacer 6mm x 2
GT2 Belt 1120mm
Support Verre_plier
flat washer narrow_am x 4
hex nut style 1_am x 4
91290A165_Black-Oxide Alloy Steel Socket Head Screw x 16
Barre Verticale x 8
Barre de compression x 8
Coussin supérieur x 8
Attache Frame x 8
Distributeur Beaumont x 8
LCD Mount - Base
LCD Mount - Handle x 2
LCD Mount - Rod x 2
LCD Mount - Rod No.2
LCD Mount - U Bracket
LCD Mount - U Bracket(Complementary)
LCD Mount - Display Hanger
HNG11000-3.stp x 2
HNG11000-2.stp x 2
HNG11000-0.stp x 2
COM56469.stp
LOC13368.stp
Com55565-5.stp
COM55087-4.stp x 2
QLB20292.stp
SCS19515.stp
Ecran
8382K66_Metal 22mm Panel-Mount Lever Switch
Servo Moteur
Bras actionneur
