skyrimax/Autobar/Conception/Axe lineaire/Axe linéaire.SLDASM

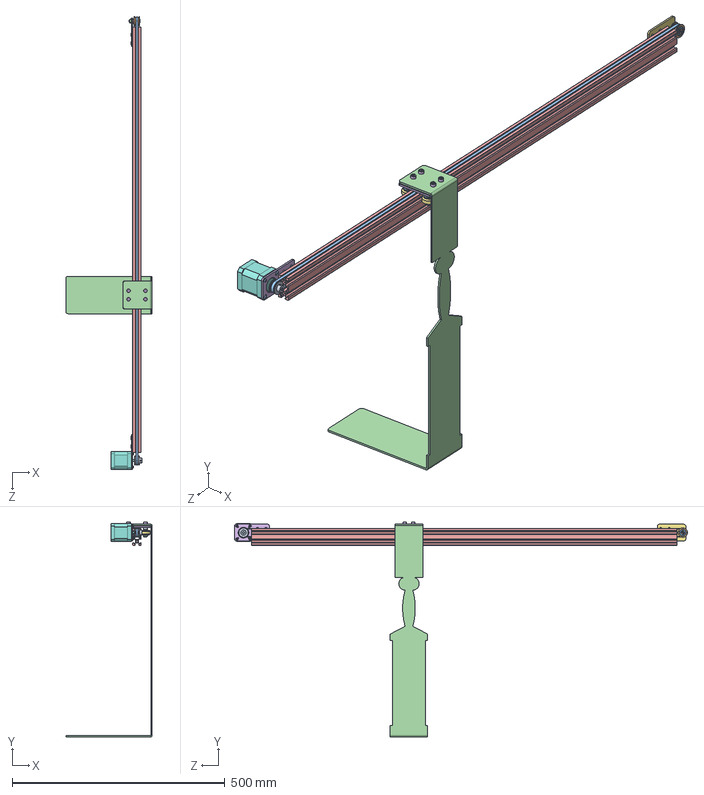
[picture p36: CAD file, 2021-08-18]
Conception/Axe lineaire/Axe linéaire.SLDASM
203.0 x 505.0 x 1064.2 mm
Double Tee Nut x 2
Low Profile Screw M5 x 9
Button Head Socket Cap Screw M3 x 4
Nylon Insert Lock Nut M5 x 5
V-Slot 20x40x1000 Linear Rail
Motor Mount Plate Nema 17
Idler Pulley Plate
Nema 17 Stepper Motor
GT2 Timing Pulley 30 Tooth
Smooth Idler Pulley Wheel
Ball Bearing 5 x 16 x 5 x 10
Nylon Spacer 0.125in
Aluminum Spacer 3mm
V-Slot Gantry Plate 20mm
Solid V Wheel x 4
Precision Shim 10 x 5 x 1 x 8
Aluminum Spacer 6mm x 2
Eccentric Spacer 6mm x 2
GT2 Belt 1120mm
Support Verre_plier
flat washer narrow_am x 4
socket head cap screw_am x 4
hex nut style 1_am x 4
