skyrimax/Autobar/Conception/Support à Bouteilles/Mécanisme de support.SLDASM

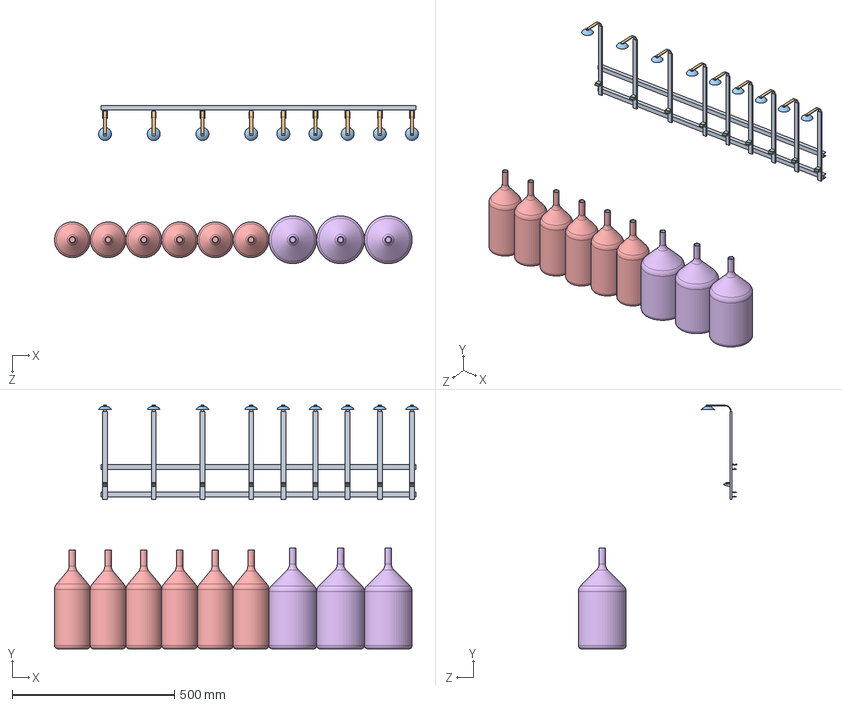
[picture p37: CAD file, 2021-08-18]
Conception/Support à Bouteilles/Mécanisme de support.SLDASM
1120.4 x 750.2 x 487.3 mm
Frame Principal
Barre de compression x 9
Coussin supérieur x 9
Attache Frame x 9
bouteille 110 mm x 6
bouteille 147 mm x 3
