skyrimax/Autobar/Conception/Support à Bouteilles/Support a 1 bouteille.SLDASM

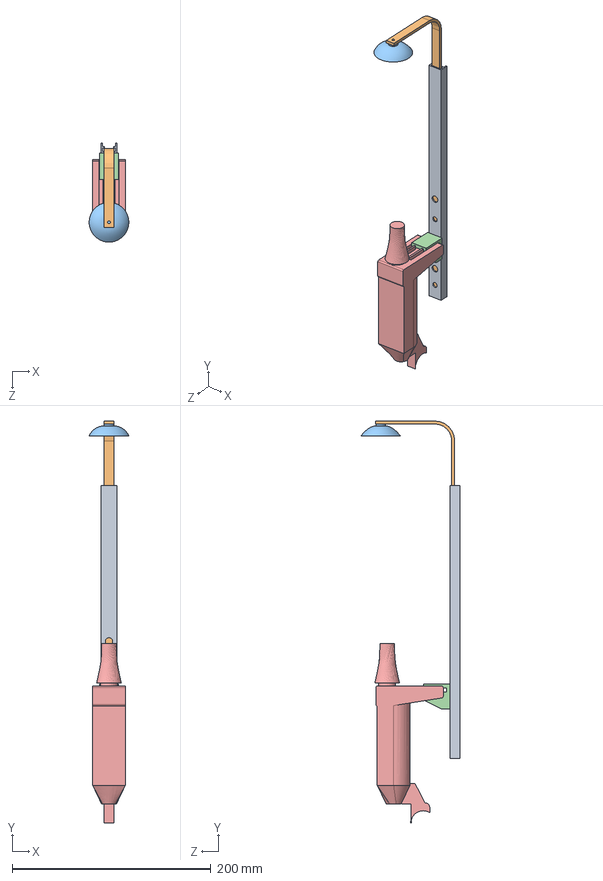
[picture p38: CAD file, 2021-08-18]
Conception/Support à Bouteilles/Support a 1 bouteille.SLDASM
40.0 x 405.0 x 100.0 mm
Barre Verticale
Barre de compression
Coussin supérieur
Attache Frame
Distributeur Beaumont
