skyrimax/Autobar/Conception/Assemblage Interface Utilisateur/TV support/led-lcd-tv-wall-mount-vesa-1.snapshot.11/LCD Display Mount/LCD Assembly.SLDASM

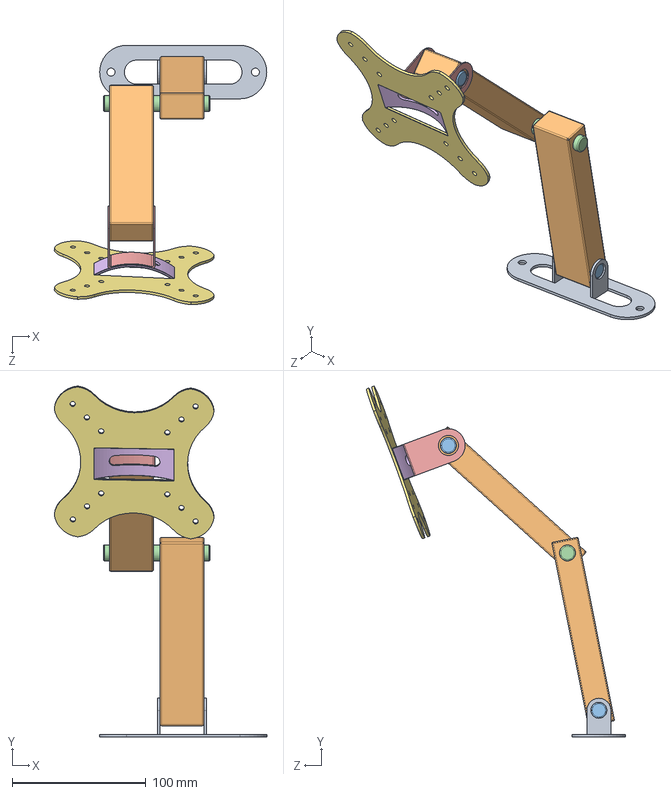
[picture p40: CAD file, 2021-08-18]
Conception/Assemblage Interface Utilisateur/TV support/led-lcd-tv-wall-mount-vesa-1.snapshot.11/LCD Display Mount/LCD Assembly.SLDASM
159.0 x 262.6 x 193.9 mm
LCD Mount - Base
LCD Mount - Handle x 2
LCD Mount - Rod x 2
LCD Mount - Rod No.2
LCD Mount - U Bracket
LCD Mount - U Bracket(Complementary)
LCD Mount - Display Hanger
