skyrimax/Autobar/Conception/Axe lineaire/Axe_1000mm/Nema 23 V Slot Belt Driven Actuator 1000mm.SLDASM

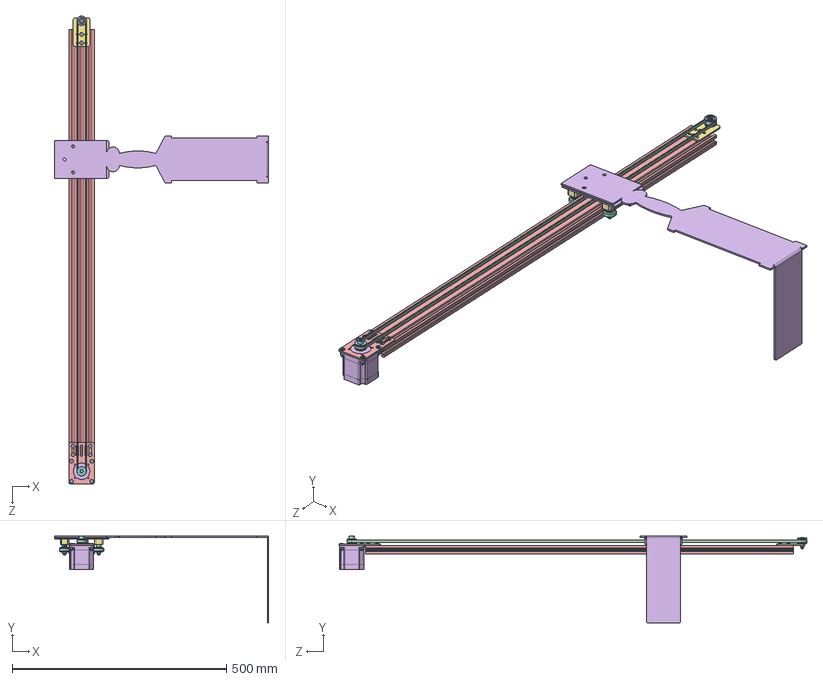
[picture p41: CAD file, 2021-08-18]
Conception/Axe lineaire/Axe_1000mm/Nema 23 V Slot Belt Driven Actuator 1000mm.SLDASM
500.0 x 203.0 x 1092.7 mm
Low Profile Screw M5 x 21
Double Tee Nut x 3
Nylon Insert Lock Nut M5 x 9
Tee Nut x 2
V-Slot 20x60x500 Linear Rail
V-Slot Gantry Plate 20-80mm
Spacer Block x 2
Solid V Wheel x 4
Ball Bearing 5 x 16 x 5 x 10
Precision Shim 10 x 5 x 1 x 8
Eccentric Spacer 6mm x 2
Aluminum Spacer 6mm x 2
Motor Mount Plate Nema 23
Nema 23 Stepper Motor
Idler Pulley Plate
GT3 Timing Pulley 20 Tooth
Smooth Idler Pulley Wheel
Nylon Spacer 0.125in
Precision Shim 8 x 5 x 1
GT3 Belt 1160mm
Aluminum Spacer 9mm x 2
Support Verre
