skyrimax/Autobar/Conception/Axe lineaire/Axe_1000mm_Nema17/Smooth Idler.SLDASM

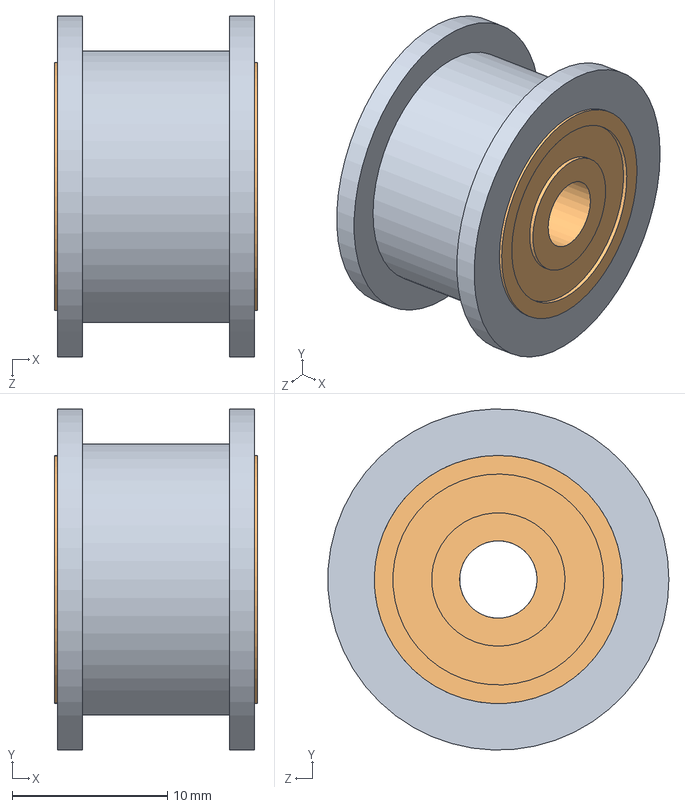
[picture p42: CAD file, 2021-08-18]
Conception/Axe lineaire/Axe_1000mm_Nema17/Smooth Idler.SLDASM
13.1 x 22.0 x 22.0 mm
Smooth Idler Pulley Wheel
Ball Bearing 5 x 16 x 5 x 2
Nylon Spacer 0.125in
