skyrimax/Autobar/Conception/Assemblage Interface Utilisateur/Box/CHKO12126/CHKO12126.stp

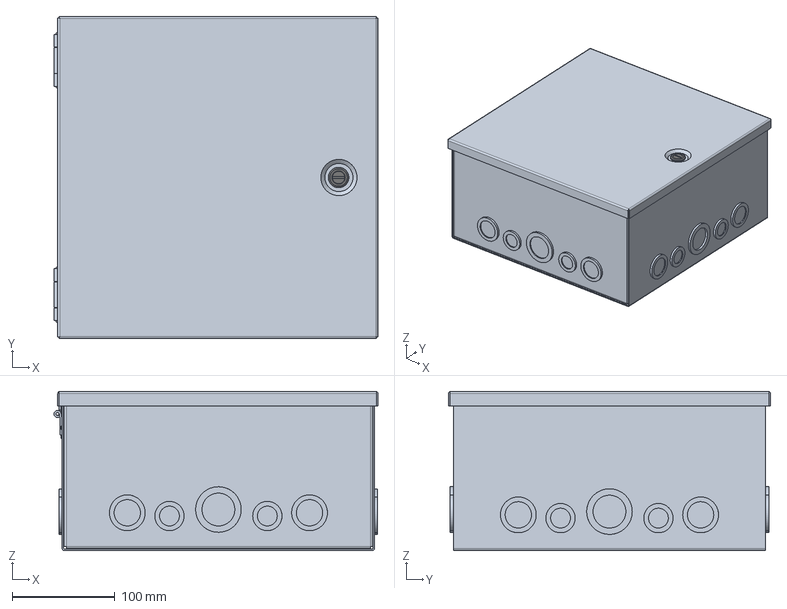
[picture p44: CAD file, 2021-08-18]
Conception/Assemblage Interface Utilisateur/Box/CHKO12126/CHKO12126.stp
316.1 x 314.5 x 155.4 mm
COM56469
HNG11000-3 x 2
HNG11000-2 x 2
HNG11000 x 2
LOC13368
Com55565-5
COM55087-4 x 2
QLB20292
SCS19515
