skyrimax/Autobar/Conception/Assemblage Interface Utilisateur/Screen/Ecran.SLDPRT

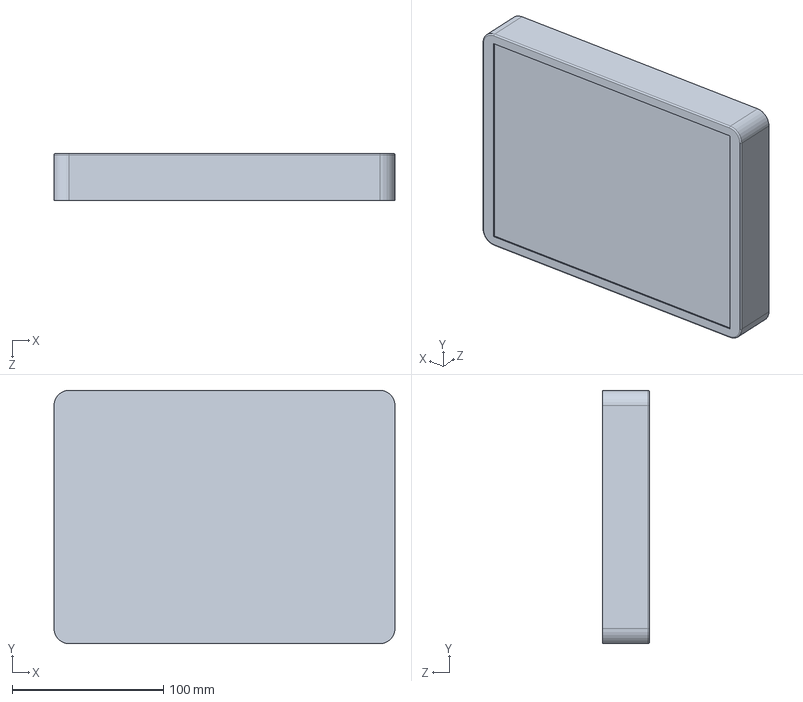
[picture p45: CAD file, 2021-08-18]
Conception/Assemblage Interface Utilisateur/Screen/Ecran.SLDPRT
225.3 x 167.4 x 31.2 mm
