skyrimax/Autobar/Conception/Assemblage Interface Utilisateur/TV support/led-lcd-tv-wall-mount-vesa-1.snapshot.11/LCD Display Mount/LCD Mount - Rod.SLDPRT

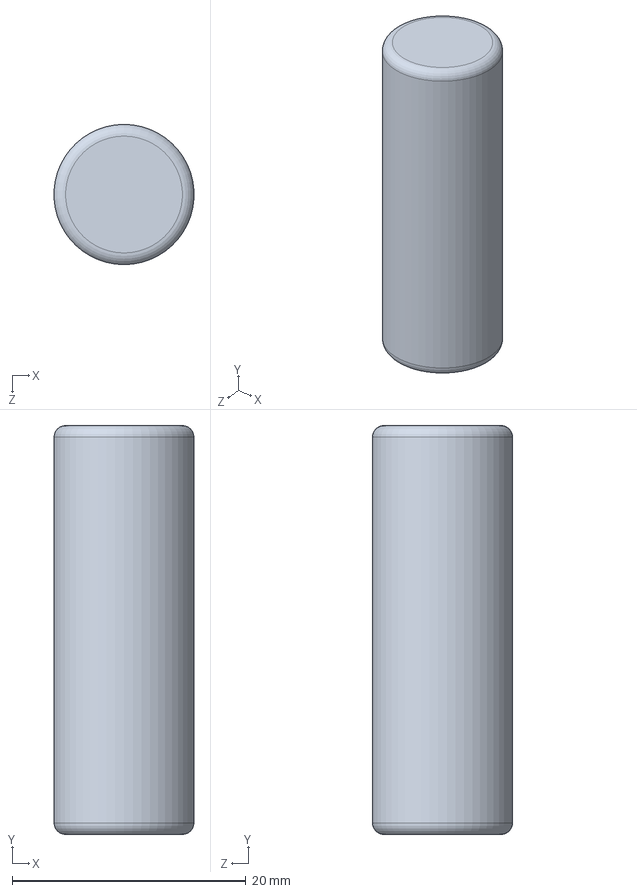
[picture p46: CAD file, 2021-08-18]
Conception/Assemblage Interface Utilisateur/TV support/led-lcd-tv-wall-mount-vesa-1.snapshot.11/LCD Display Mount/LCD Mount - Rod.SLDPRT
12.0 x 35.0 x 12.0 mm
