skyrimax/Autobar/Conception/Axe lineaire/Axe_1000mm/Motor Mount Plate Nema 23.SLDPRT

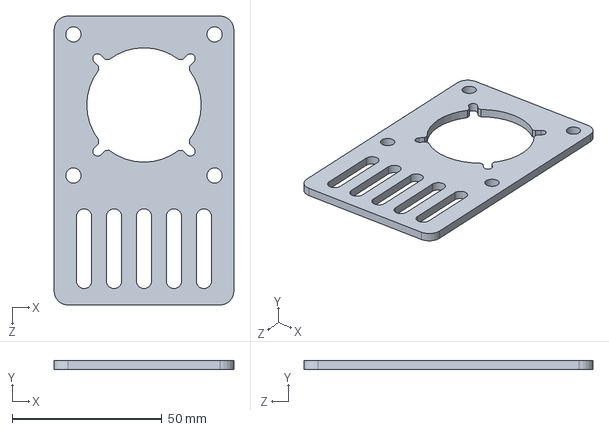
[picture p47: CAD file, 2021-08-18]
Conception/Axe lineaire/Axe_1000mm/Motor Mount Plate Nema 23.SLDPRT
60.0 x 3.00 x 96.5 mm
