skyrimax/Autobar/Conception/Axe lineaire/Support Verre_plier.SLDPRT

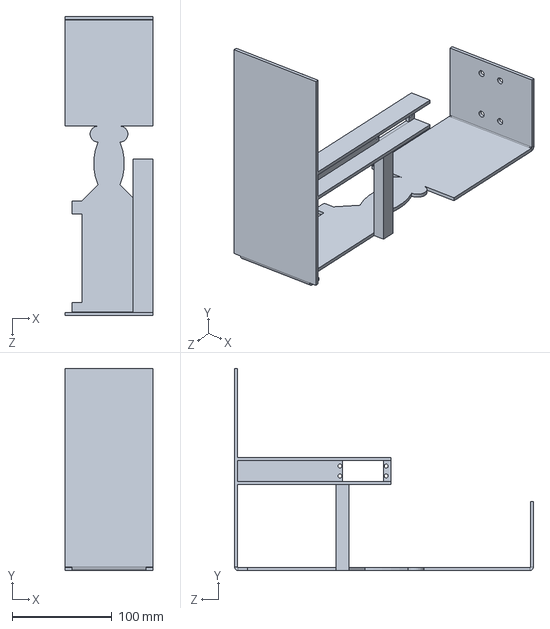
[picture p48: CAD file, 2021-08-18]
Conception/Axe lineaire/Support Verre_plier.SLDPRT
88.0 x 203.0 x 300.0 mm
