skyrimax/Autobar/Conception/Support à Bouteilles/Barre Verticale.SLDPRT

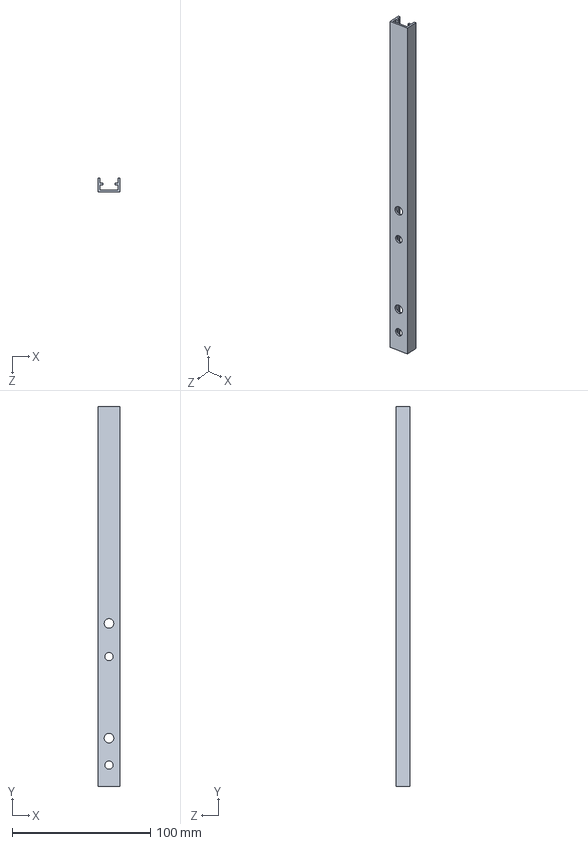
[picture p49: CAD file, 2021-08-18]
Conception/Support à Bouteilles/Barre Verticale.SLDPRT
16.0 x 275.0 x 10.0 mm
