skyrimax/Autobar/Conception/Actionneur à bouteilles/Bras actionneur.SLDPRT

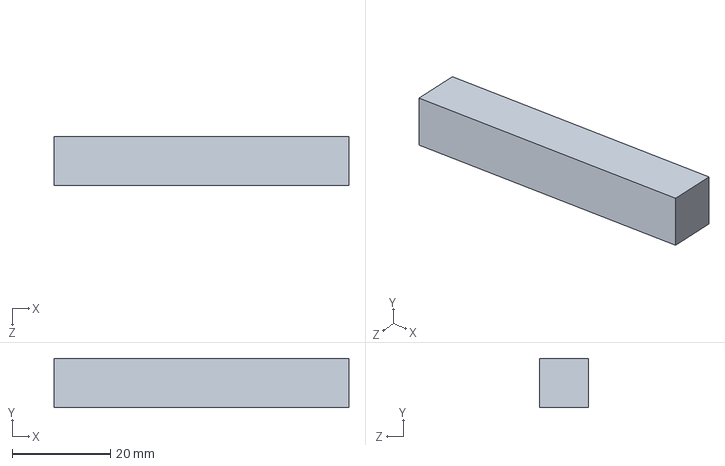
[picture p50: CAD file, 2021-08-18]
Conception/Actionneur à bouteilles/Bras actionneur.SLDPRT
60.0 x 10.0 x 10.0 mm
