skyrimax/Autobar/Conception/Assemblage Interface Utilisateur/TV support/led-lcd-tv-wall-mount-vesa-1.snapshot.11/LCD Display Mount/LCD Mount - Rod No.2.SLDPRT

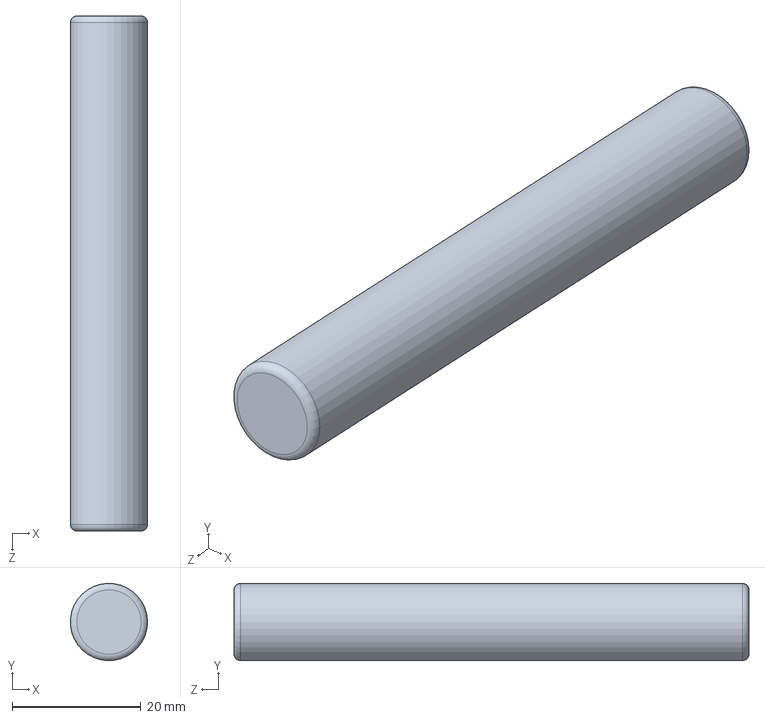
[picture p51: CAD file, 2021-08-18]
Conception/Assemblage Interface Utilisateur/TV support/led-lcd-tv-wall-mount-vesa-1.snapshot.11/LCD Display Mount/LCD Mount - Rod No.2.SLDPRT
12.0 x 12.0 x 80.0 mm
