skyrimax/Autobar/Conception/Axe lineaire/Axe_1000mm/Aluminum Spacer 9mm.SLDPRT

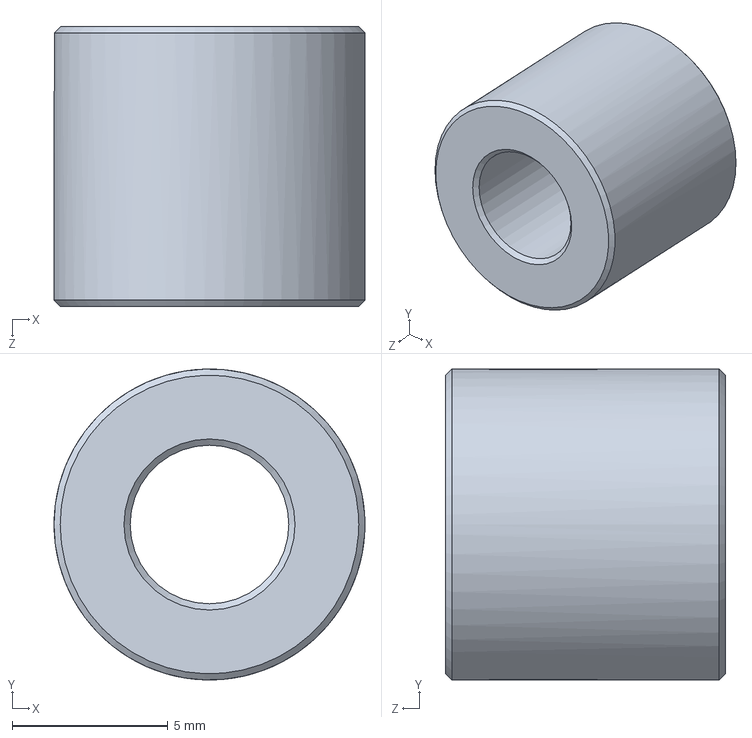
[picture p52: CAD file, 2021-08-18]
Conception/Axe lineaire/Axe_1000mm/Aluminum Spacer 9mm.SLDPRT
10.0 x 9.99 x 9.00 mm
