skyrimax/Autobar/Conception/Axe lineaire/Axe_1000mm_Nema17/Nylon Spacer 0.125in.SLDPRT

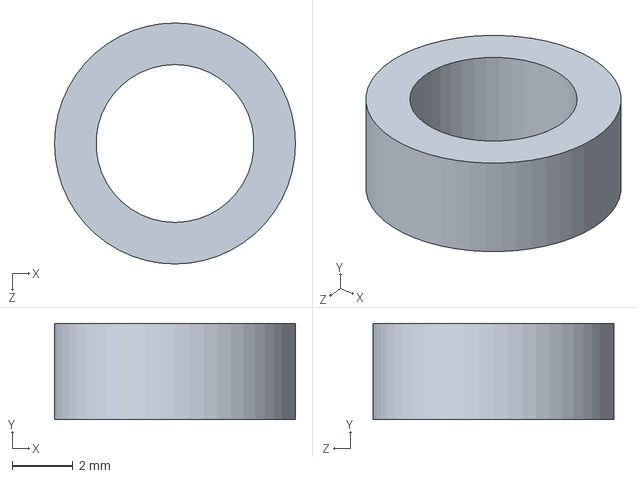
[picture p53: CAD file, 2021-08-18]
Conception/Axe lineaire/Axe_1000mm_Nema17/Nylon Spacer 0.125in.SLDPRT
7.94 x 3.17 x 7.94 mm
