skyrimax/Autobar/Conception/Axe lineaire/Nema 23 V-Slot Belt Driven Actuator.step

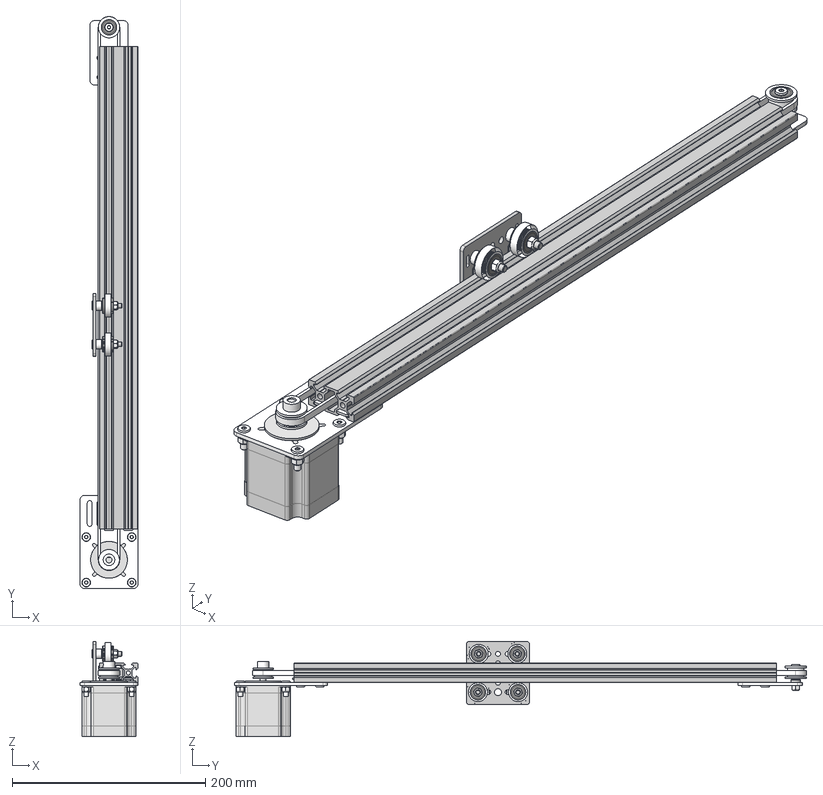
[picture p54: CAD file, 2021-08-18]
Conception/Axe lineaire/Nema 23 V-Slot Belt Driven Actuator.step
60.0 x 592.6 x 98.6 mm
V-Slot Gantry Plate 20mm
V-Slot 20x40x500 Linear Rail
Aluminum Spacer 3mm
Low Profile Screw M5 v1 x 4
