skyrimax/Autobar/Conception/Base/Flatbed.SLDPRT

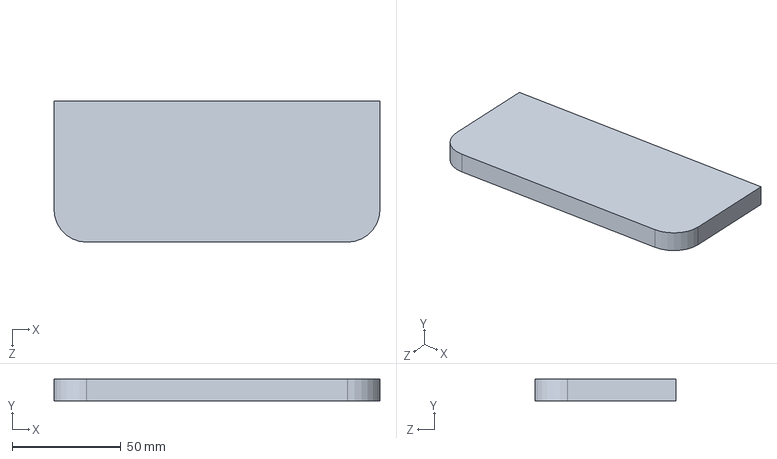
[picture p55: CAD file, 2021-08-18]
Conception/Base/Flatbed.SLDPRT
150.0 x 10.0 x 65.0 mm
