skyrimax/Autobar/Conception/Fit bouteilles/bouteille 147 mm.SLDPRT

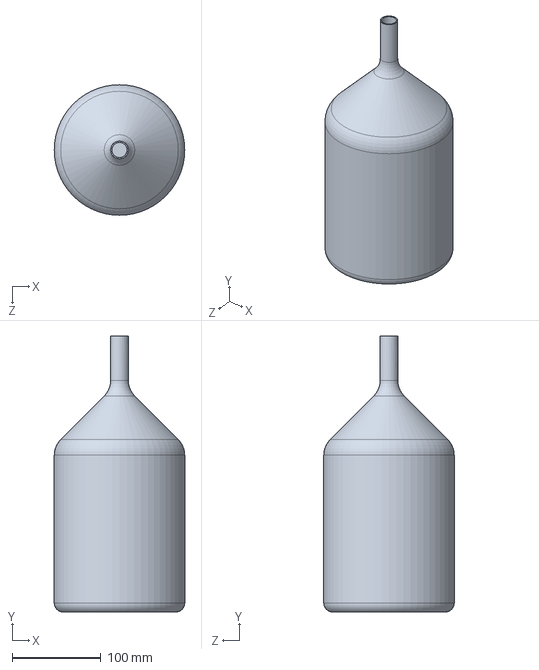
[picture p56: CAD file, 2021-08-18]
Conception/Fit bouteilles/bouteille 147 mm.SLDPRT
147.0 x 310.8 x 147.0 mm
