skyrimax/Autobar/Conception/Support à Bouteilles/Barre de compression.SLDPRT

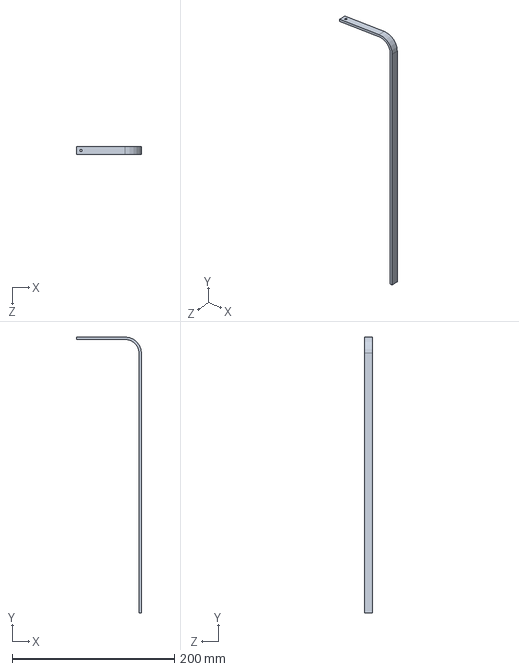
[picture p57: CAD file, 2021-08-18]
Conception/Support à Bouteilles/Barre de compression.SLDPRT
80.0 x 340.0 x 10.0 mm
