skyrimax/Autobar/Conception/Actionneur à bouteilles/Servo Moteur.SLDPRT

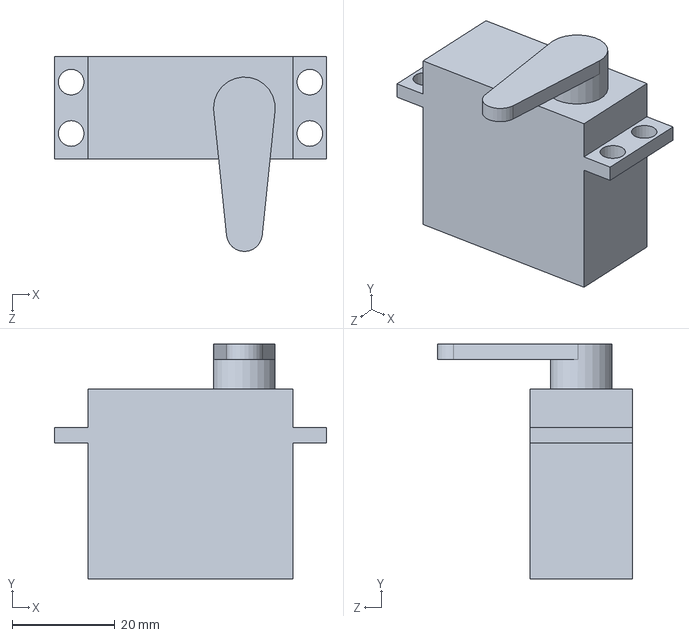
[picture p58: CAD file, 2021-08-18]
Conception/Actionneur à bouteilles/Servo Moteur.SLDPRT
53.0 x 45.7 x 38.0 mm
