skyrimax/Autobar/Conception/Assemblage Interface Utilisateur/TV support/led-lcd-tv-wall-mount-vesa-1.snapshot.11/LCD Display Mount/LCD Mount - U Bracket(Complementary).SLDPRT

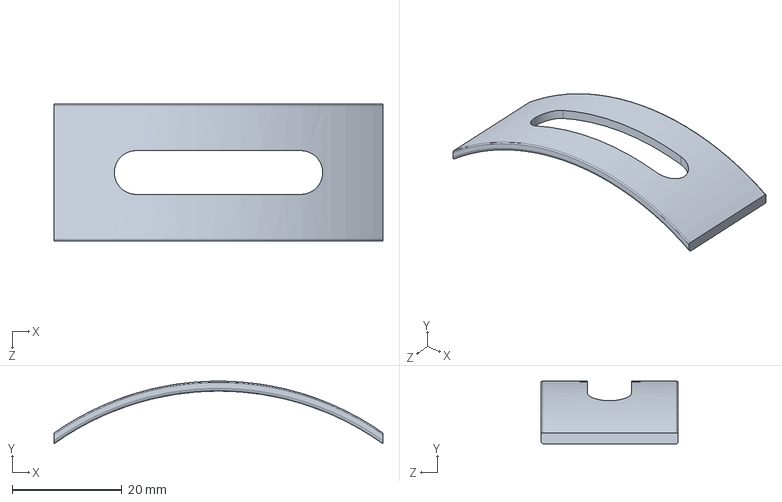
[picture p59: CAD file, 2021-08-18]
Conception/Assemblage Interface Utilisateur/TV support/led-lcd-tv-wall-mount-vesa-1.snapshot.11/LCD Display Mount/LCD Mount - U Bracket(Complementary).SLDPRT
60.0 x 11.4 x 25.0 mm
