skyrimax/Autobar/Conception/Axe lineaire/Axe_1000mm/Eccentric Spacer 6mm.SLDPRT

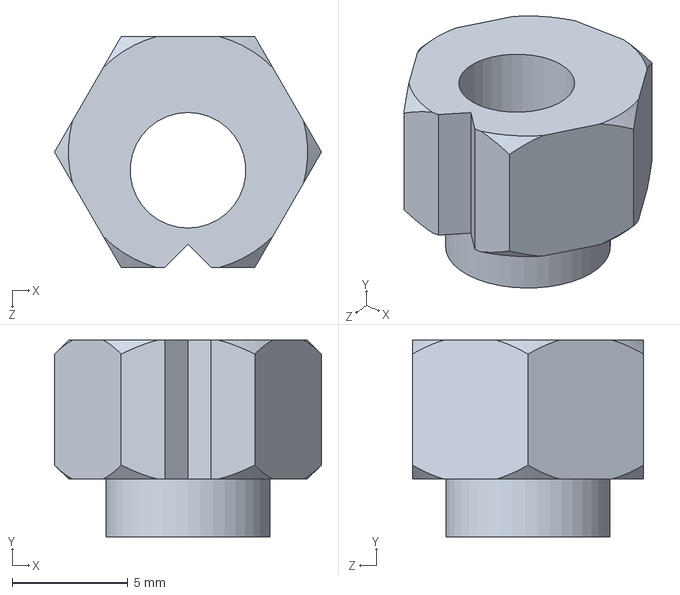
[picture p60: CAD file, 2021-08-18]
Conception/Axe lineaire/Axe_1000mm/Eccentric Spacer 6mm.SLDPRT
11.5 x 8.50 x 10.0 mm
