skyrimax/Autobar/Conception/Base/poutre principale.SLDPRT

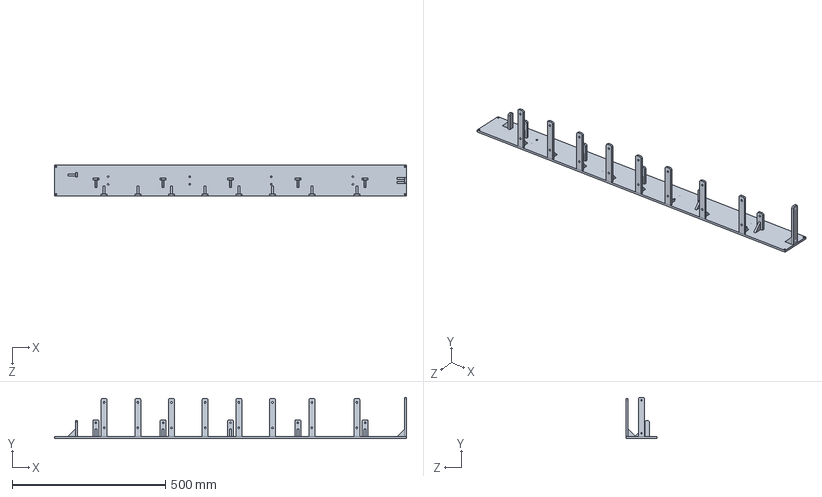
[picture p61: CAD file, 2021-08-18]
Conception/Base/poutre principale.SLDPRT
1150.0 x 134.4 x 100.0 mm
