skyrimax/Autobar/Conception/Fit bouteilles/bouteille 110 mm.SLDPRT

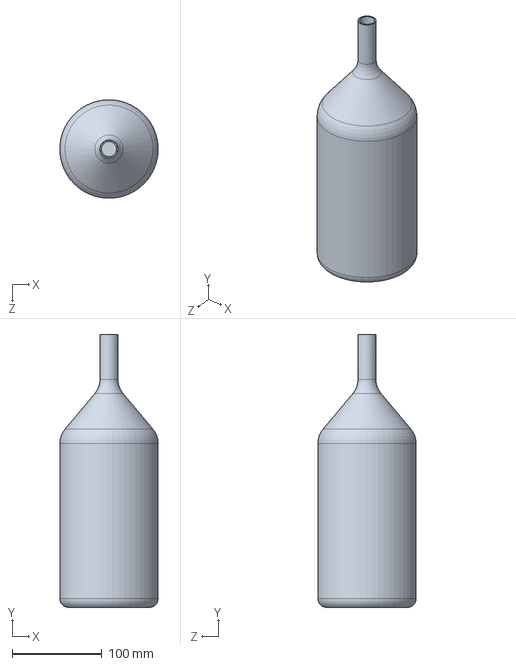
[picture p62: CAD file, 2021-08-18]
Conception/Fit bouteilles/bouteille 110 mm.SLDPRT
109.9 x 305.0 x 109.9 mm
