skyrimax/Autobar/Conception/Support à Bouteilles/Attache Frame.SLDPRT

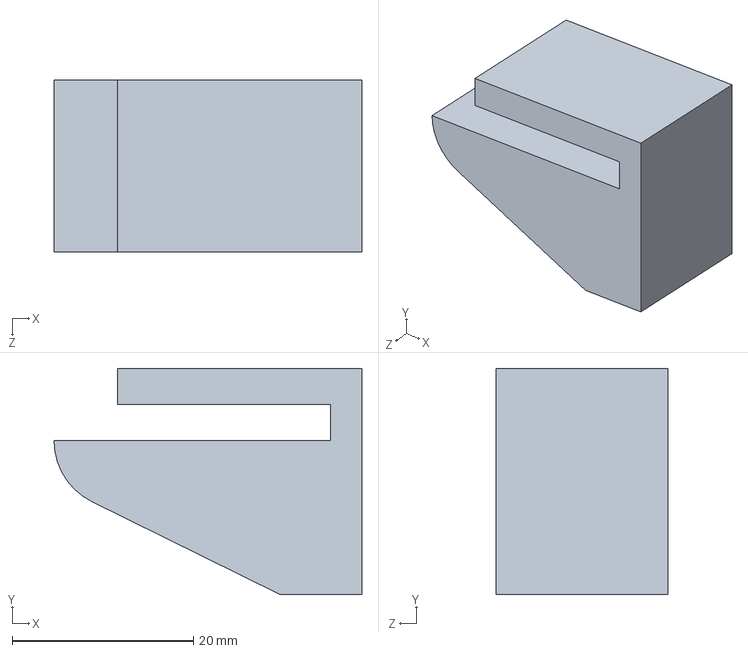
[picture p63: CAD file, 2021-08-18]
Conception/Support à Bouteilles/Attache Frame.SLDPRT
34.0 x 25.0 x 19.0 mm
