skyrimax/Autobar/Conception/Assemblage Interface Utilisateur/TV support/led-lcd-tv-wall-mount-vesa-1.snapshot.11/LCD Display Mount/LCD Mount - Base.SLDPRT

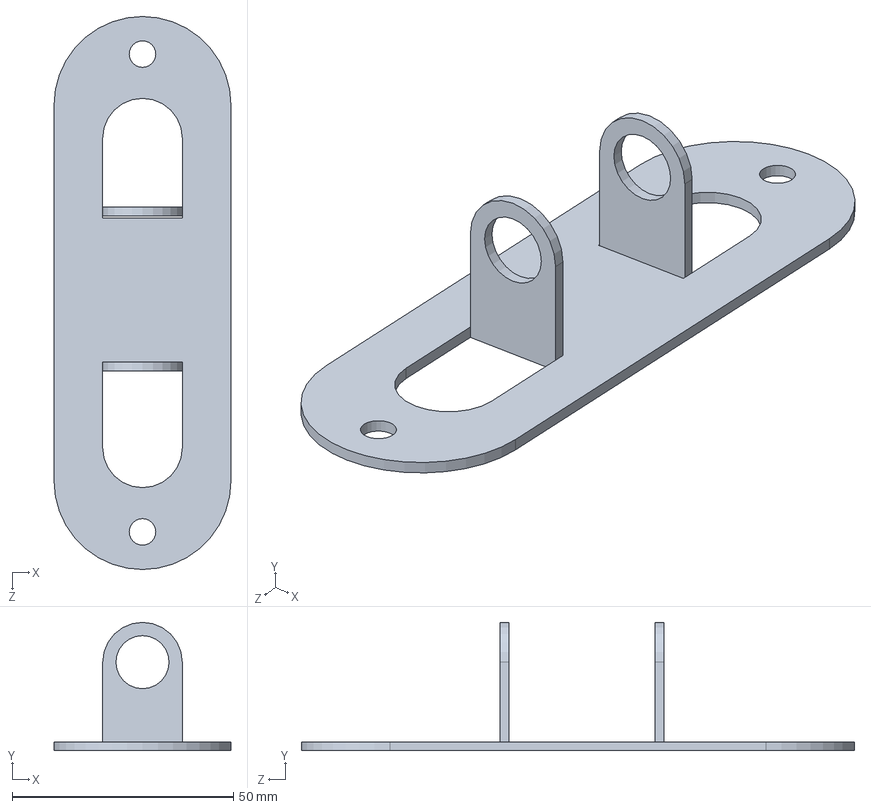
[picture p64: CAD file, 2021-08-18]
Conception/Assemblage Interface Utilisateur/TV support/led-lcd-tv-wall-mount-vesa-1.snapshot.11/LCD Display Mount/LCD Mount - Base.SLDPRT
40.0 x 29.0 x 125.0 mm
