skyrimax/Autobar/Conception/Axe lineaire/Axe_1000mm/GT3 Belt 1160mm.SLDPRT

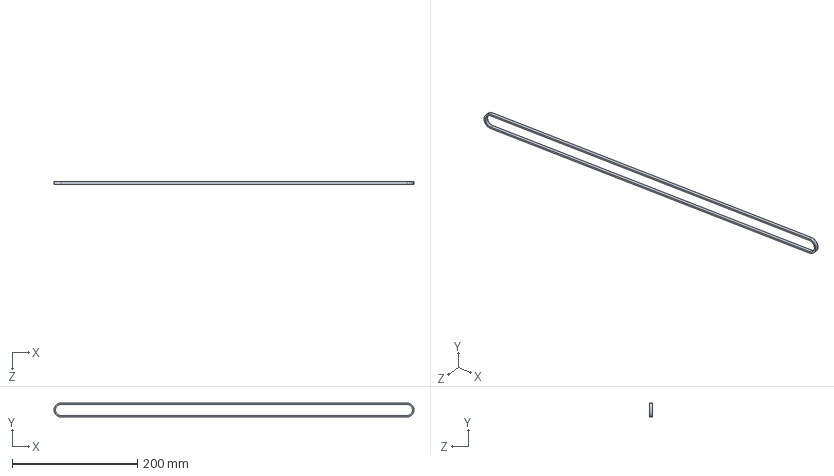
[picture p65: CAD file, 2021-08-18]
Conception/Axe lineaire/Axe_1000mm/GT3 Belt 1160mm.SLDPRT
574.1 x 22.3 x 5.00 mm
