skyrimax/Autobar/Conception/Axe lineaire/Axe_1000mm_Nema17/GT2 Timing Pulley 30 Tooth.SLDPRT

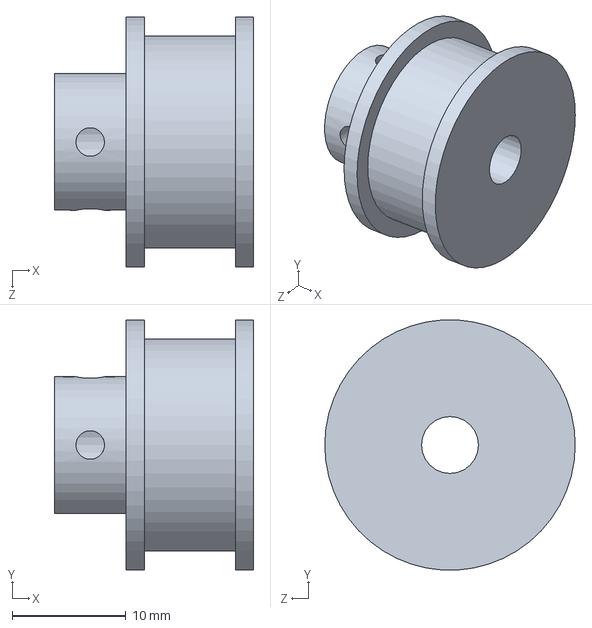
[picture p66: CAD file, 2021-08-18]
Conception/Axe lineaire/Axe_1000mm_Nema17/GT2 Timing Pulley 30 Tooth.SLDPRT
17.5 x 22.0 x 22.0 mm
