skyrimax/Autobar/Conception/Base/Cloison.SLDPRT

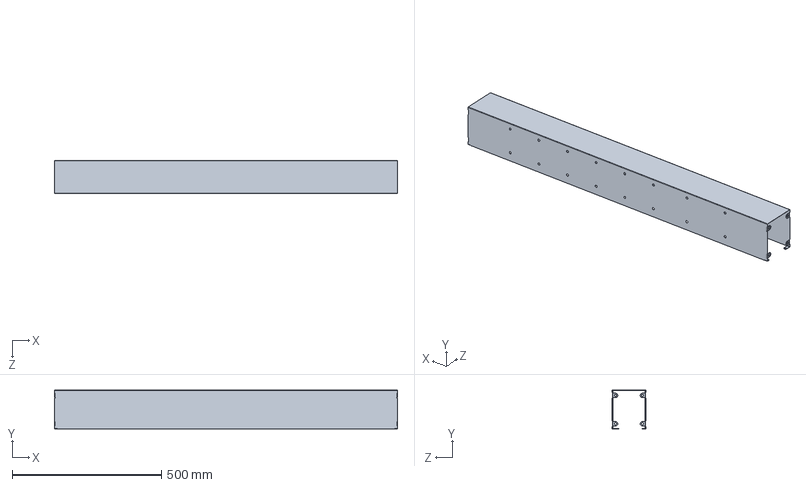
[picture p67: CAD file, 2021-08-18]
Conception/Base/Cloison.SLDPRT
1150.0 x 130.7 x 111.5 mm
