skyrimax/Autobar/Conception/Axe lineaire/Axe_1000mm/Aluminum Spacer 6mm.SLDPRT

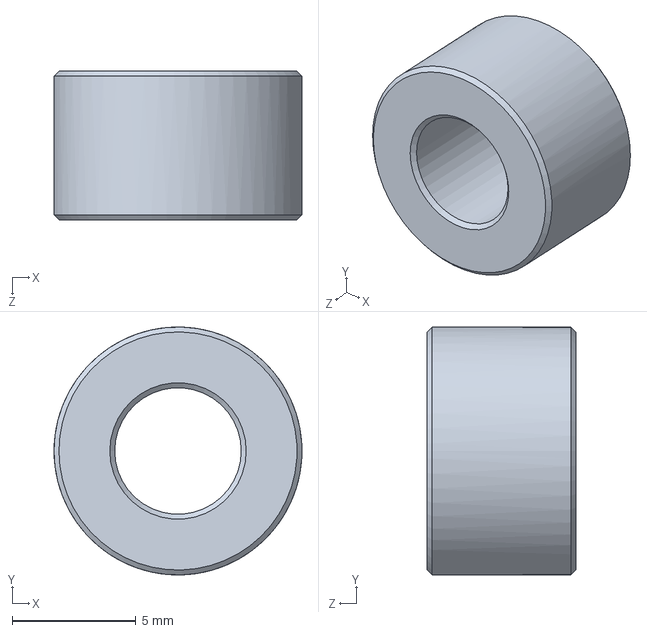
[picture p69: CAD file, 2021-08-18]
Conception/Axe lineaire/Axe_1000mm/Aluminum Spacer 6mm.SLDPRT
10.0 x 10.00 x 6.00 mm
