skyrimax/Autobar/Conception/Axe lineaire/Axe_1000mm_Nema17/Motor Mount Plate Nema 17.SLDPRT

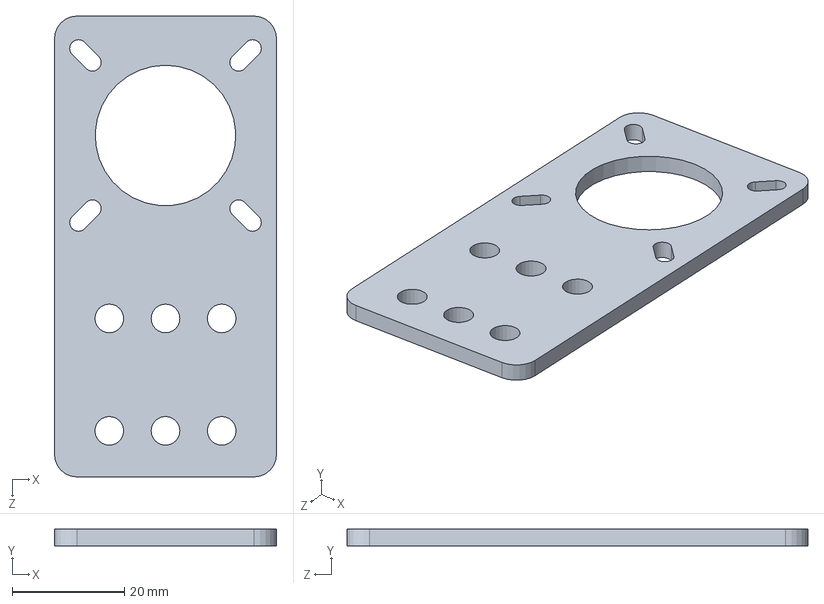
[picture p70: CAD file, 2021-08-18]
Conception/Axe lineaire/Axe_1000mm_Nema17/Motor Mount Plate Nema 17.SLDPRT
39.5 x 3.00 x 82.0 mm
