skyrimax/Autobar/Conception/Support à Bouteilles/Frame Principal.SLDPRT

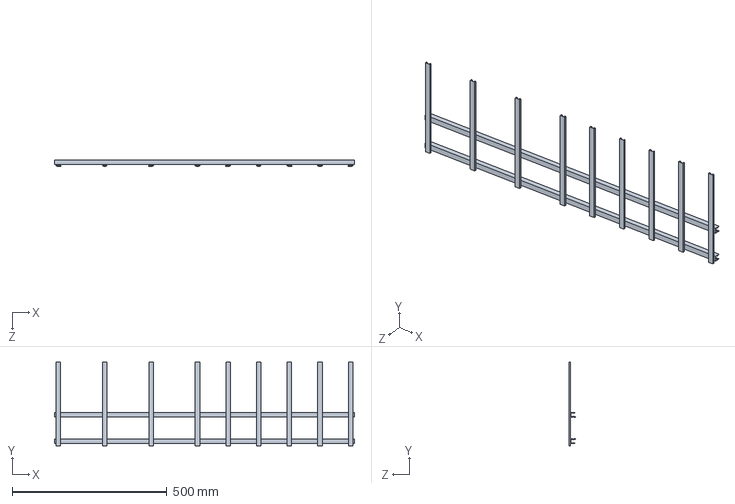
[picture p71: CAD file, 2021-08-18]
Conception/Support à Bouteilles/Frame Principal.SLDPRT
970.0 x 270.0 x 20.0 mm
