skyrimax/Autobar/Conception/Axe lineaire/Axe_1000mm/Idler Pulley Plate.SLDPRT

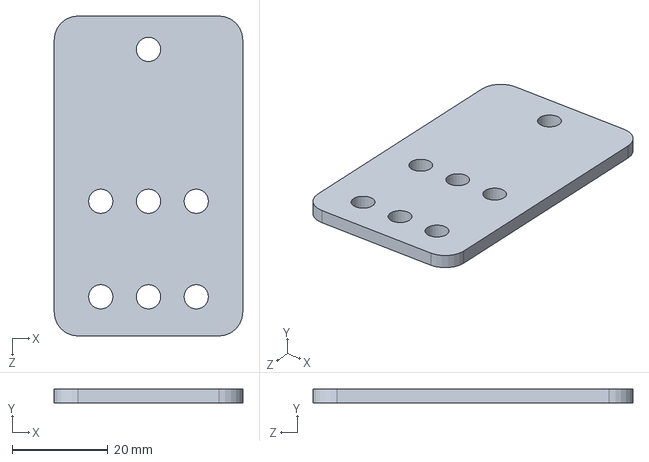
[picture p73: CAD file, 2021-08-18]
Conception/Axe lineaire/Axe_1000mm/Idler Pulley Plate.SLDPRT
39.5 x 3.00 x 67.0 mm
