skyrimax/Autobar/Conception/Base/Couvert cloison.SLDPRT

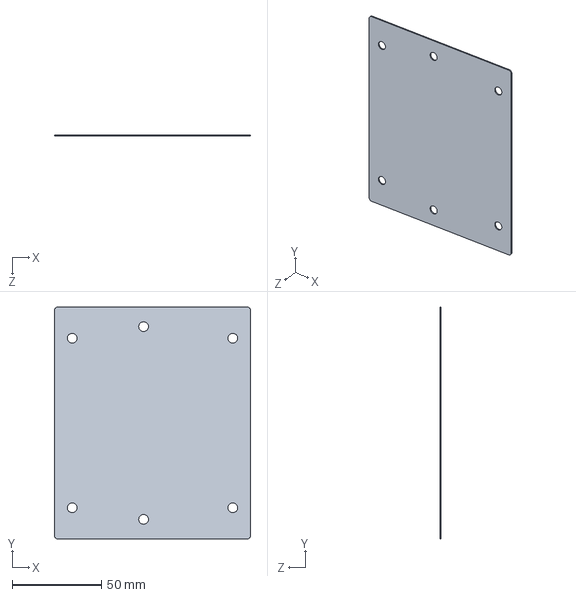
[picture p74: CAD file, 2021-08-18]
Conception/Base/Couvert cloison.SLDPRT
110.0 x 130.0 x 0.737 mm
