skyrimax/Autobar/Conception/Support à Bouteilles/Coussin supérieur.SLDPRT

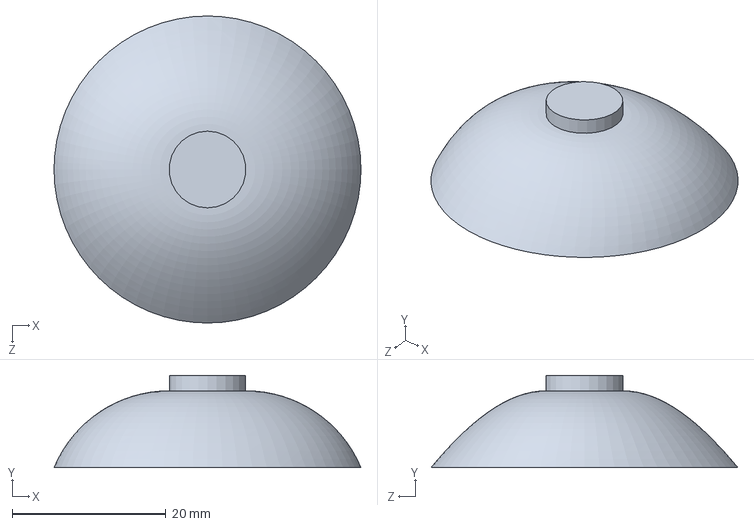
[picture p75: CAD file, 2021-08-18]
Conception/Support à Bouteilles/Coussin supérieur.SLDPRT
40.0 x 12.0 x 40.0 mm
