skyrimax/Autobar/Conception/Axe lineaire/Axe_1000mm/GT3 Timing Pulley 20 Tooth.SLDPRT

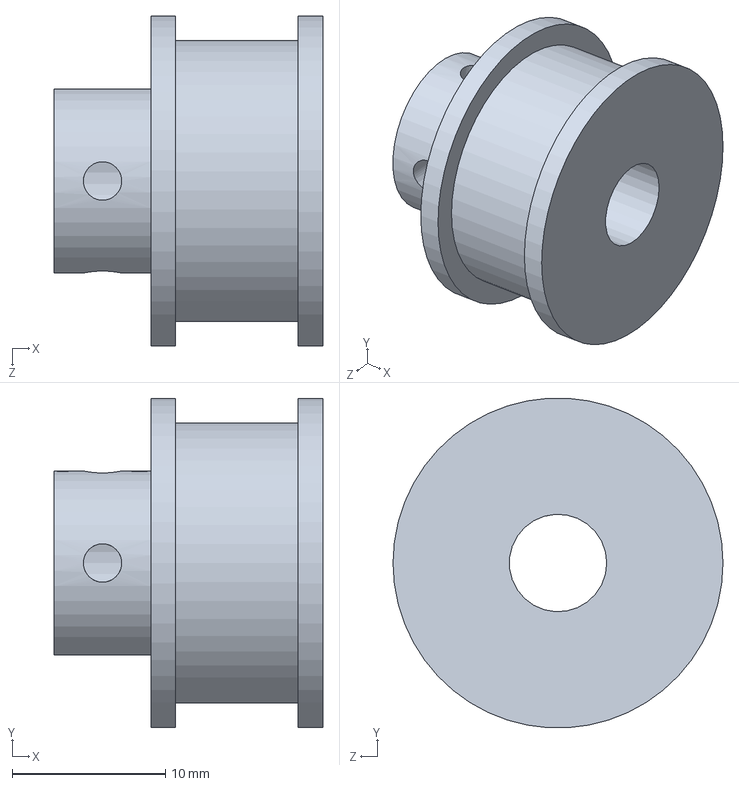
[picture p77: CAD file, 2021-08-18]
Conception/Axe lineaire/Axe_1000mm/GT3 Timing Pulley 20 Tooth.SLDPRT
17.5 x 21.5 x 21.5 mm
