skyrimax/Autobar/Conception/Axe lineaire/Axe_1000mm_Nema17/Smooth Idler Pulley Wheel.SLDPRT

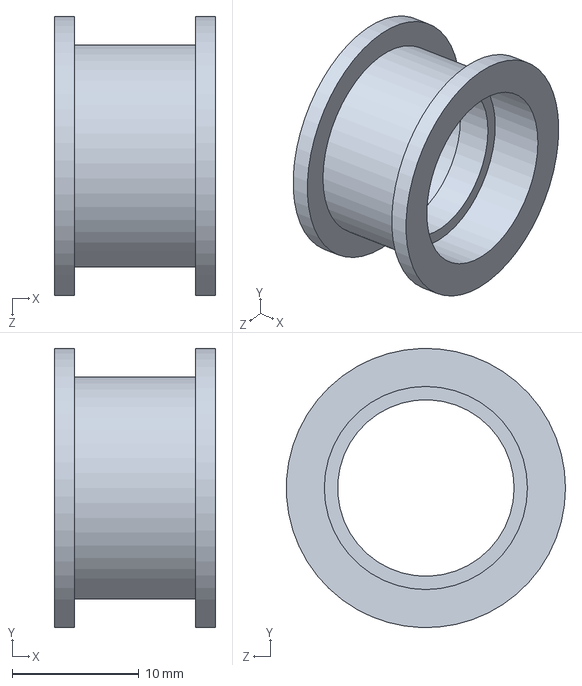
[picture p78: CAD file, 2021-08-18]
Conception/Axe lineaire/Axe_1000mm_Nema17/Smooth Idler Pulley Wheel.SLDPRT
12.7 x 22.0 x 22.0 mm
