skyrimax/Autobar/Conception/Base/pattes.SLDPRT

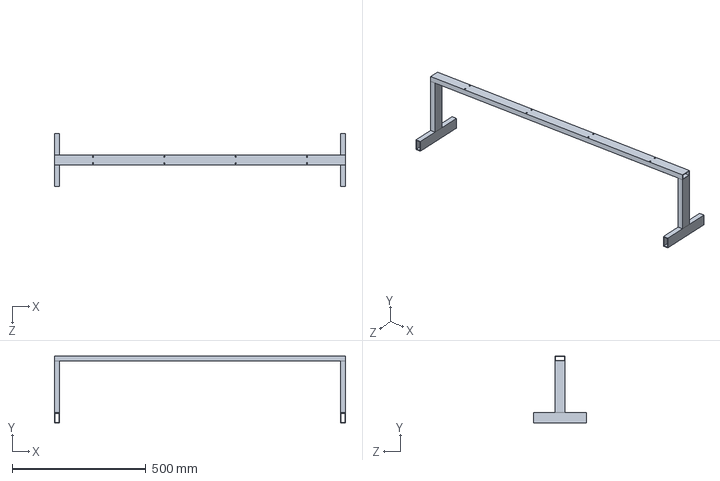
[picture p79: CAD file, 2021-08-18]
Conception/Base/pattes.SLDPRT
1088.1 x 250.0 x 200.0 mm
