skyrimax/Autobar/Conception/Axe lineaire/Axe_1000mm_Nema17/V-Slot Gantry Plate 20mm.SLDPRT

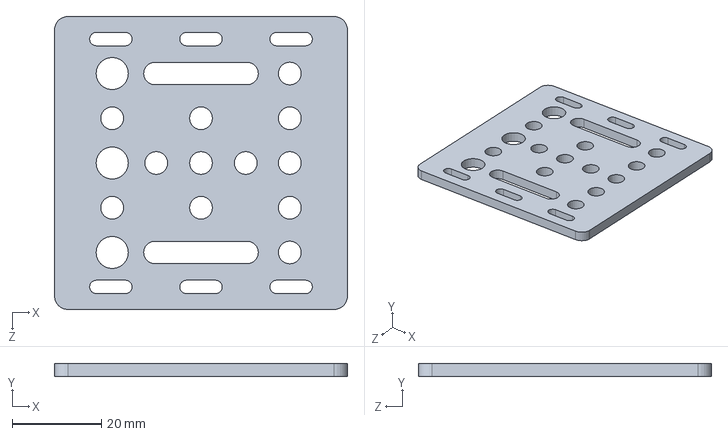
[picture p81: CAD file, 2021-08-18]
Conception/Axe lineaire/Axe_1000mm_Nema17/V-Slot Gantry Plate 20mm.SLDPRT
65.5 x 3.00 x 65.5 mm
