skyrimax/Autobar/Conception/Support à Bouteilles/Distributeur Beaumont.SLDPRT

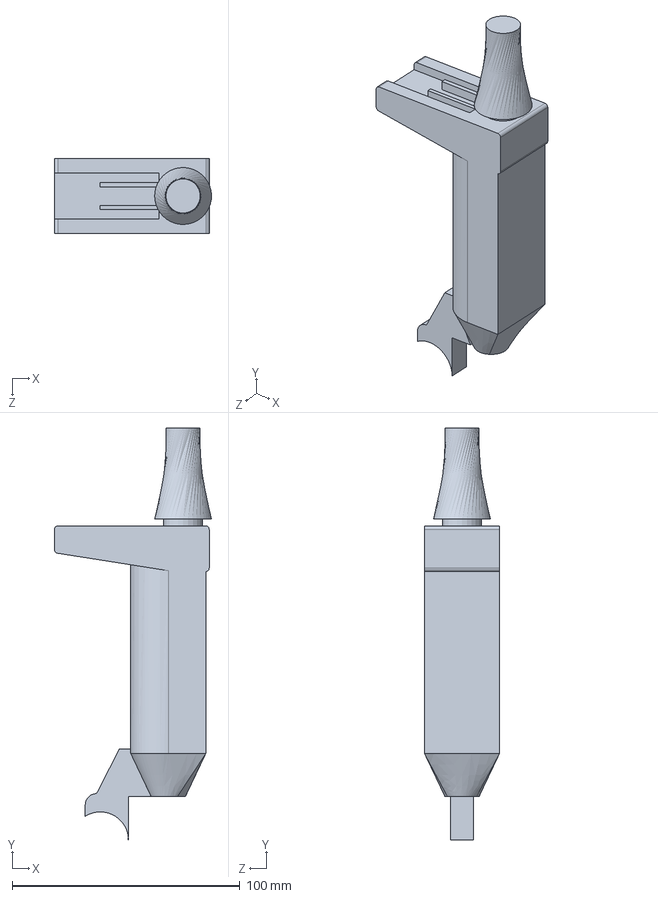
[picture p82: CAD file, 2021-08-18]
Conception/Support à Bouteilles/Distributeur Beaumont.SLDPRT
69.0 x 181.0 x 33.0 mm
