skyrimax/Autobar/Conception/Axe lineaire/Axe_1000mm/Precision Shim 8 x 5 x 1.SLDPRT

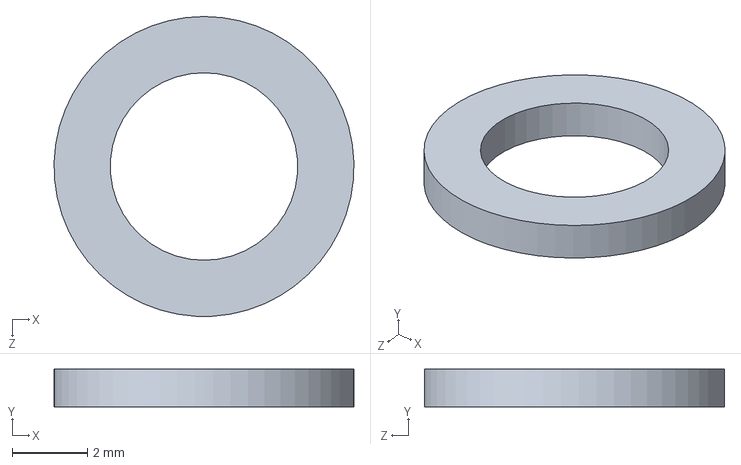
[picture p83: CAD file, 2021-08-18]
Conception/Axe lineaire/Axe_1000mm/Precision Shim 8 x 5 x 1.SLDPRT
8.00 x 1.00 x 8.00 mm
