skyrimax/Autobar/Conception/Axe lineaire/Axe_1000mm_Nema17/Ball Bearing 5 x 16 x 5.SLDPRT

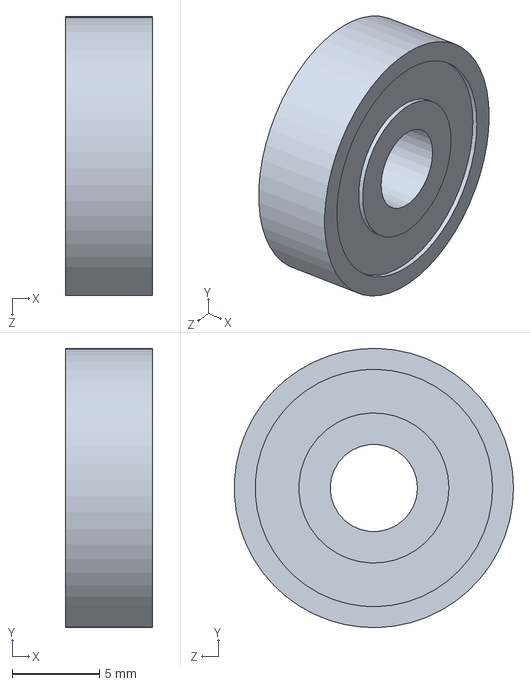
[picture p84: CAD file, 2021-08-18]
Conception/Axe lineaire/Axe_1000mm_Nema17/Ball Bearing 5 x 16 x 5.SLDPRT
5.00 x 16.0 x 16.0 mm
