skyrimax/Autobar/Conception/Axe lineaire/Axe_1000mm_Nema17/V-Slot 20x40x1000 Linear Rail.SLDPRT

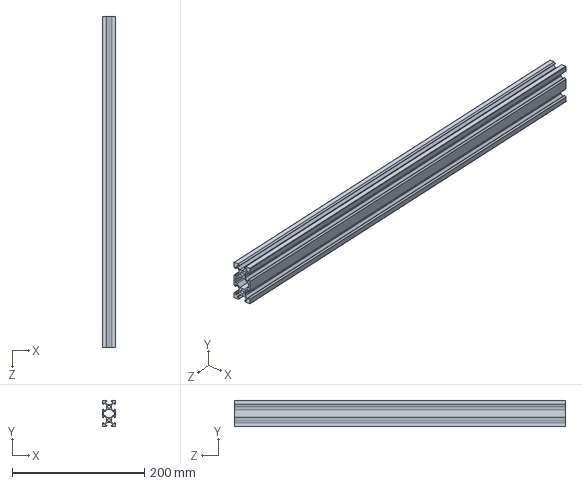
[picture p85: CAD file, 2021-08-18]
Conception/Axe lineaire/Axe_1000mm_Nema17/V-Slot 20x40x1000 Linear Rail.SLDPRT
20.0 x 40.0 x 500.0 mm
