skyrimax/Autobar/Conception/Axe lineaire/Axe_1000mm/V-Slot 20x60x500 Linear Rail.SLDPRT

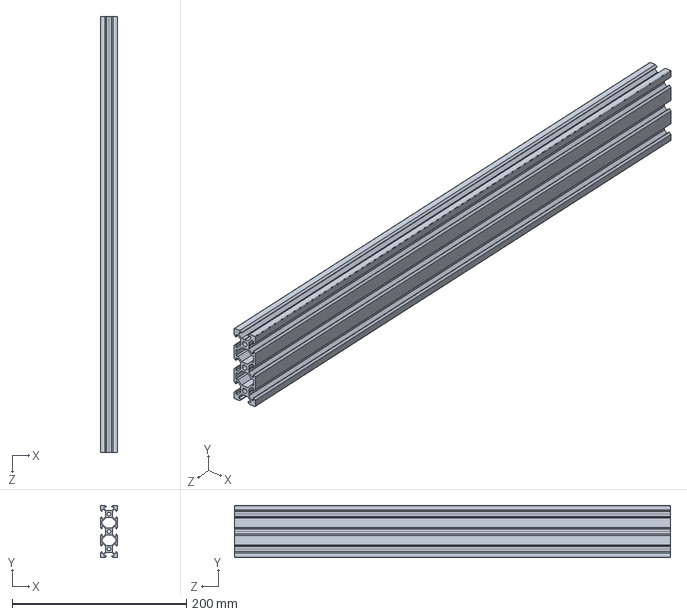
[picture p86: CAD file, 2021-08-18]
Conception/Axe lineaire/Axe_1000mm/V-Slot 20x60x500 Linear Rail.SLDPRT
20.0 x 60.0 x 500.0 mm
