skyrimax/Autobar/Conception/Axe lineaire/Axe_1000mm_Nema17/GT2 Belt 1120mm.SLDPRT

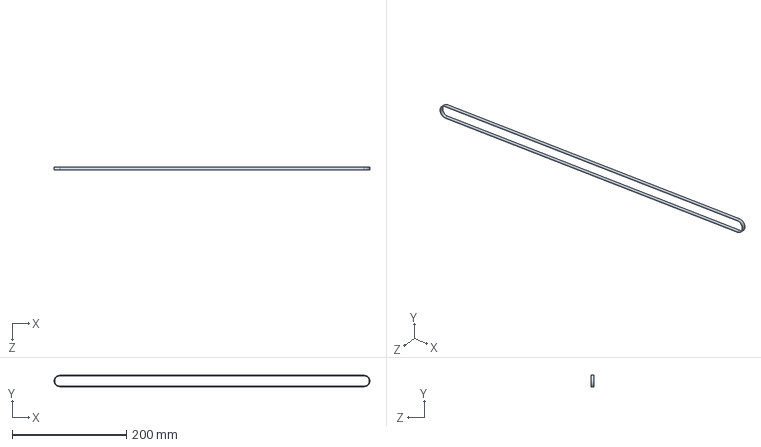
[picture p87: CAD file, 2021-08-18]
Conception/Axe lineaire/Axe_1000mm_Nema17/GT2 Belt 1120mm.SLDPRT
552.3 x 20.3 x 5.00 mm
