skyrimax/Autobar/Conception/Axe lineaire/Axe_1000mm/Support Verre.SLDPRT

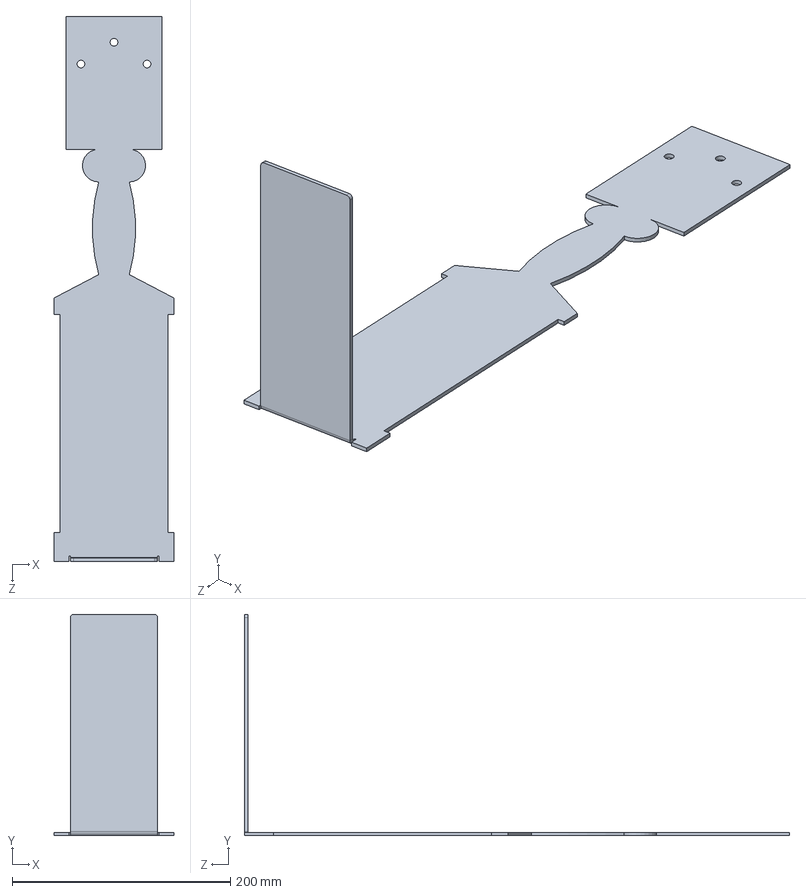
[picture p88: CAD file, 2021-08-18]
Conception/Axe lineaire/Axe_1000mm/Support Verre.SLDPRT
110.0 x 203.0 x 500.0 mm
