skyrimax/Autobar/Conception/Axe lineaire/Axe_1000mm_Nema17/Precision Shim 10 x 5 x 1.SLDPRT

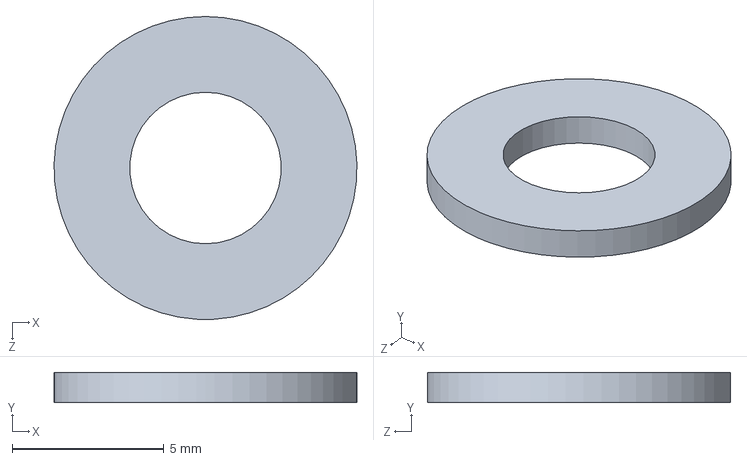
[picture p89: CAD file, 2021-08-18]
Conception/Axe lineaire/Axe_1000mm_Nema17/Precision Shim 10 x 5 x 1.SLDPRT
10.00 x 1.00 x 10.0 mm
