skyrimax/Autobar/Conception/Axe lineaire/Axe_1000mm/V-Slot Gantry Plate 20-80mm.SLDPRT

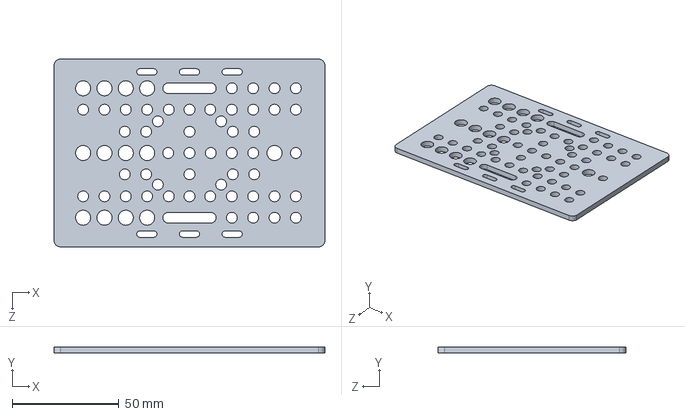
[picture p90: CAD file, 2021-08-18]
Conception/Axe lineaire/Axe_1000mm/V-Slot Gantry Plate 20-80mm.SLDPRT
127.0 x 3.00 x 88.0 mm
