skyrimax/Autobar/Conception/Axe lineaire/Axe_1000mm/Nema 23 Stepper Motor.SLDPRT

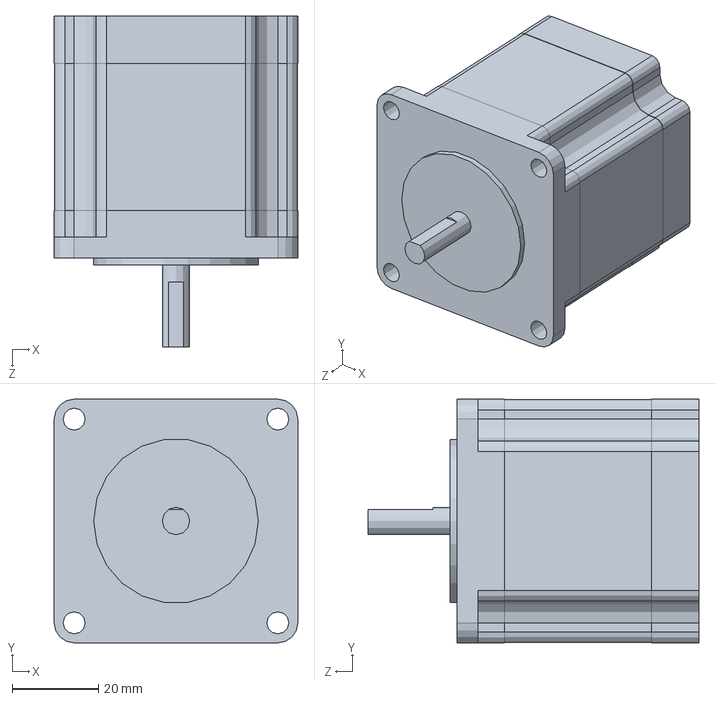
[picture p91: CAD file, 2021-08-18]
Conception/Axe lineaire/Axe_1000mm/Nema 23 Stepper Motor.SLDPRT
56.4 x 56.4 x 76.6 mm
