skyrimax/Autobar/Conception/Axe lineaire/Axe_1000mm_Nema17/Nema 17 Stepper Motor.SLDPRT

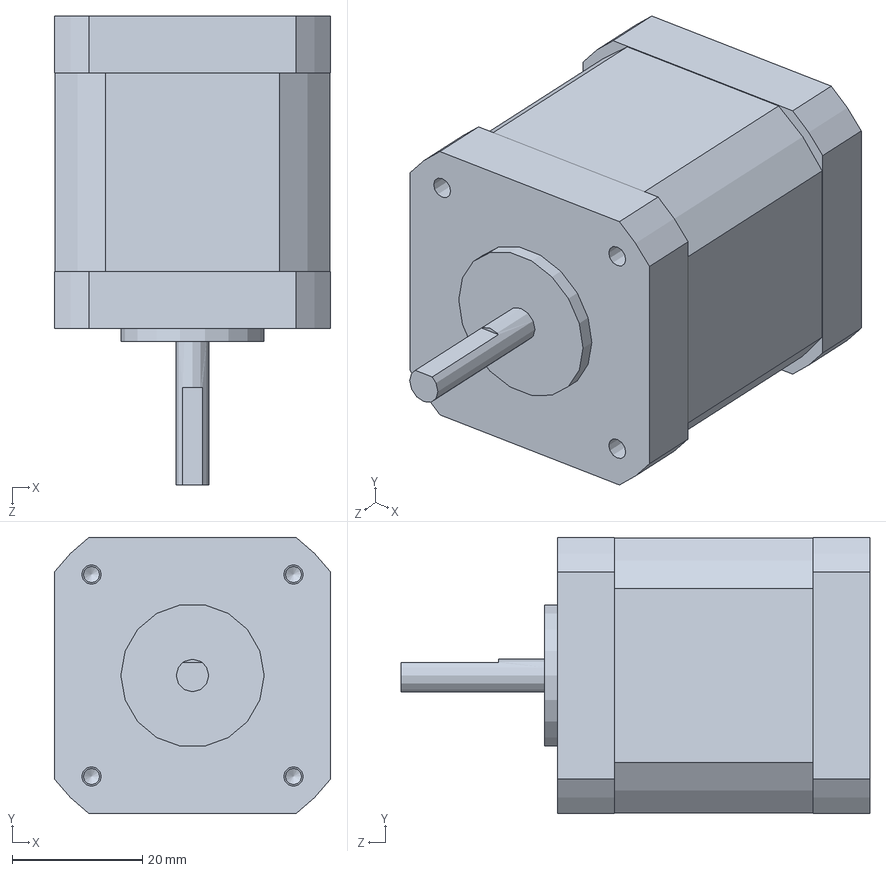
[picture p92: CAD file, 2021-08-18]
Conception/Axe lineaire/Axe_1000mm_Nema17/Nema 17 Stepper Motor.SLDPRT
42.4 x 42.4 x 72.0 mm
