skyrimax/Autobar/Conception/Axe lineaire/Axe_1000mm/Spacer Block.SLDPRT

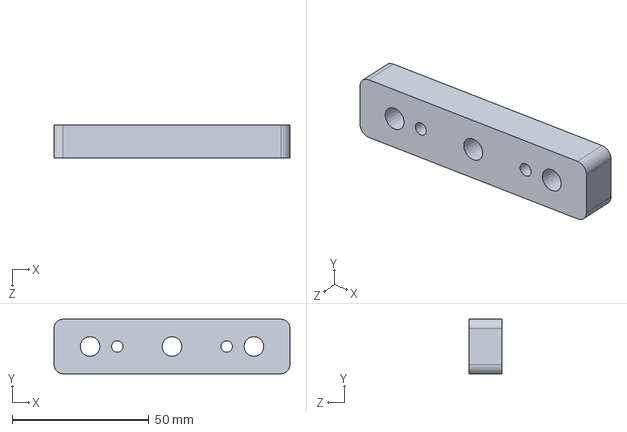
[picture p93: CAD file, 2021-08-18]
Conception/Axe lineaire/Axe_1000mm/Spacer Block.SLDPRT
86.4 x 20.0 x 12.0 mm
