skyrimax/Autobar/Conception/Axe lineaire/Axe_1000mm_Nema17/Aluminum Spacer 3mm.SLDPRT

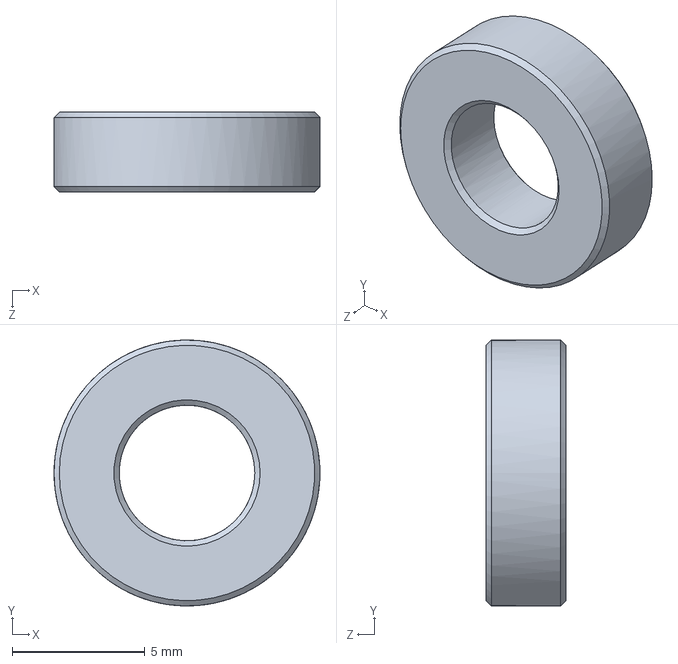
[picture p94: CAD file, 2021-08-18]
Conception/Axe lineaire/Axe_1000mm_Nema17/Aluminum Spacer 3mm.SLDPRT
10.0 x 10.00 x 3.00 mm
