skyrimax/Autobar/(list of files, cad)

Other CAD files:
Conception/Axe lineaire/D2HW_BR221M_Solidworks/D2HW_BR221M.SLDASM
Conception/Axe lineaire/Axe_1000mm/Smooth Idler.SLDASM
Conception/Axe lineaire/D2HW_BR221M_Solidworks/D2HW_BR221M_BASE.SLDPRT
Conception/Axe lineaire/D2HW_BR221M_Solidworks/D2HW_BR221M_ACTUATOR.SLDPRT
Conception/Axe lineaire/D2HW_BR221M_Solidworks/D2HW_BR221M_BUTTON.SLDPRT
Conception/Axe lineaire/Axe_1000mm_Nema17/Eccentric Spacer 6mm.SLDPRT
Conception/Axe lineaire/Axe_1000mm_Nema17/Aluminum Spacer 6mm.SLDPRT
Conception/Axe lineaire/Axe_1000mm/Nylon Spacer 0.125in.SLDPRT
Conception/Axe lineaire/Axe_1000mm/Smooth Idler Pulley Wheel.SLDPRT
Conception/Axe lineaire/Axe_1000mm_Nema17/Idler Pulley Plate.SLDPRT
Conception/Axe lineaire/Axe_1000mm/Ball Bearing 5 x 16 x 5.SLDPRT
Conception/Axe lineaire/Axe_1000mm/Precision Shim 10 x 5 x 1.SLDPRT
Conception/Assemblage Interface Utilisateur/Box/CHKO12126/CHKO12126.SLDASM
Conception/Assemblage Interface Utilisateur/Switch/8382K66_Metal 22mm Panel-Mount Lever Switch.SLDPRT
Conception/Axe lineaire/Axe_1000mm/Double Tee Nut.SLDPRT
Conception/Axe lineaire/Axe_1000mm/Low Profile Screw M5.SLDPRT
Conception/Axe lineaire/Axe_1000mm/Nylon Insert Lock Nut M5.SLDPRT
Conception/Axe lineaire/Axe_1000mm/Solid V Wheel.SLDPRT
Conception/Axe lineaire/Axe_1000mm/Tee Nut.SLDPRT
Conception/Axe lineaire/Axe_1000mm_Nema17/Button Head Socket Cap Screw M3.SLDPRT
Conception/Axe lineaire/Axe_1000mm_Nema17/Double Tee Nut.SLDPRT
Conception/Axe lineaire/Axe_1000mm_Nema17/Low Profile Screw M5.SLDPRT
Conception/Axe lineaire/Axe_1000mm_Nema17/Nylon Insert Lock Nut M5.SLDPRT
Conception/Axe lineaire/Axe_1000mm_Nema17/Solid V Wheel.SLDPRT
Conception/Axe lineaire/D2HW_BR221M_Solidworks/D2HW_BR221M.SLDDRW
Conception/Base/95105A175_ZINC-PLATED STEEL HEAVY-DUTY RIVET NUT.SLDPRT
Conception/Fastener/91290A162_Black-Oxide Alloy Steel Socket Head Screw.SLDPRT
Conception/Fastener/91290A165_Black-Oxide Alloy Steel Socket Head Screw.SLDPRT
