skyrimax/Autobar/Conception/Assemblage Interface Utilisateur/Screen/AffichageMenu.PNG

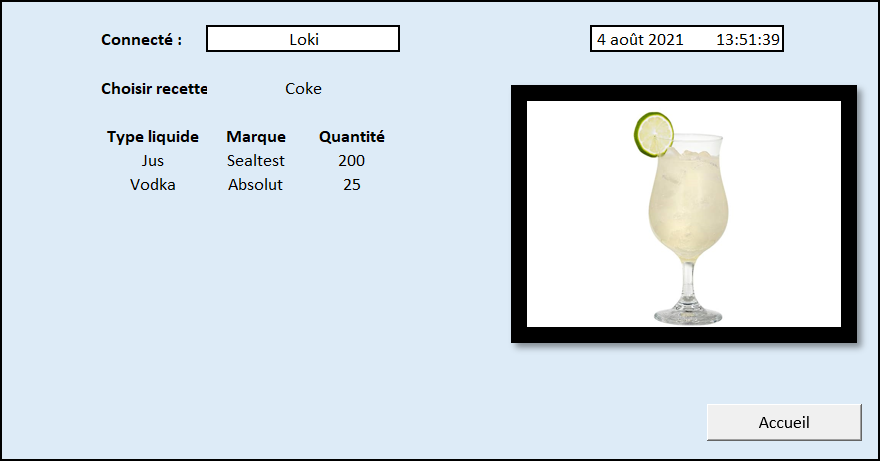
Conception/Assemblage Interface Utilisateur/Screen/AffichageMenu.PNG
