skyrimax/Autobar/Document Remise/Rapport définition projet/RdP_criteres_evaluation.pdf

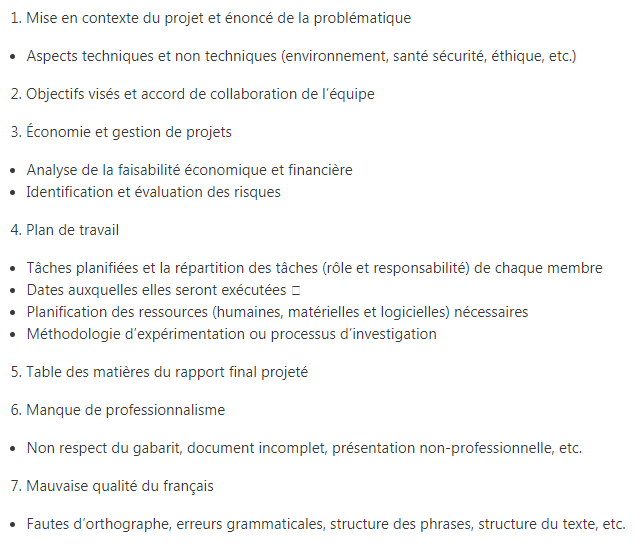
[picture p96: page 1]
