skyrimax/Autobar/Document Remise/Rapport final/Base donnée/Entité-Association.pdf

## Entité-Association Étendue

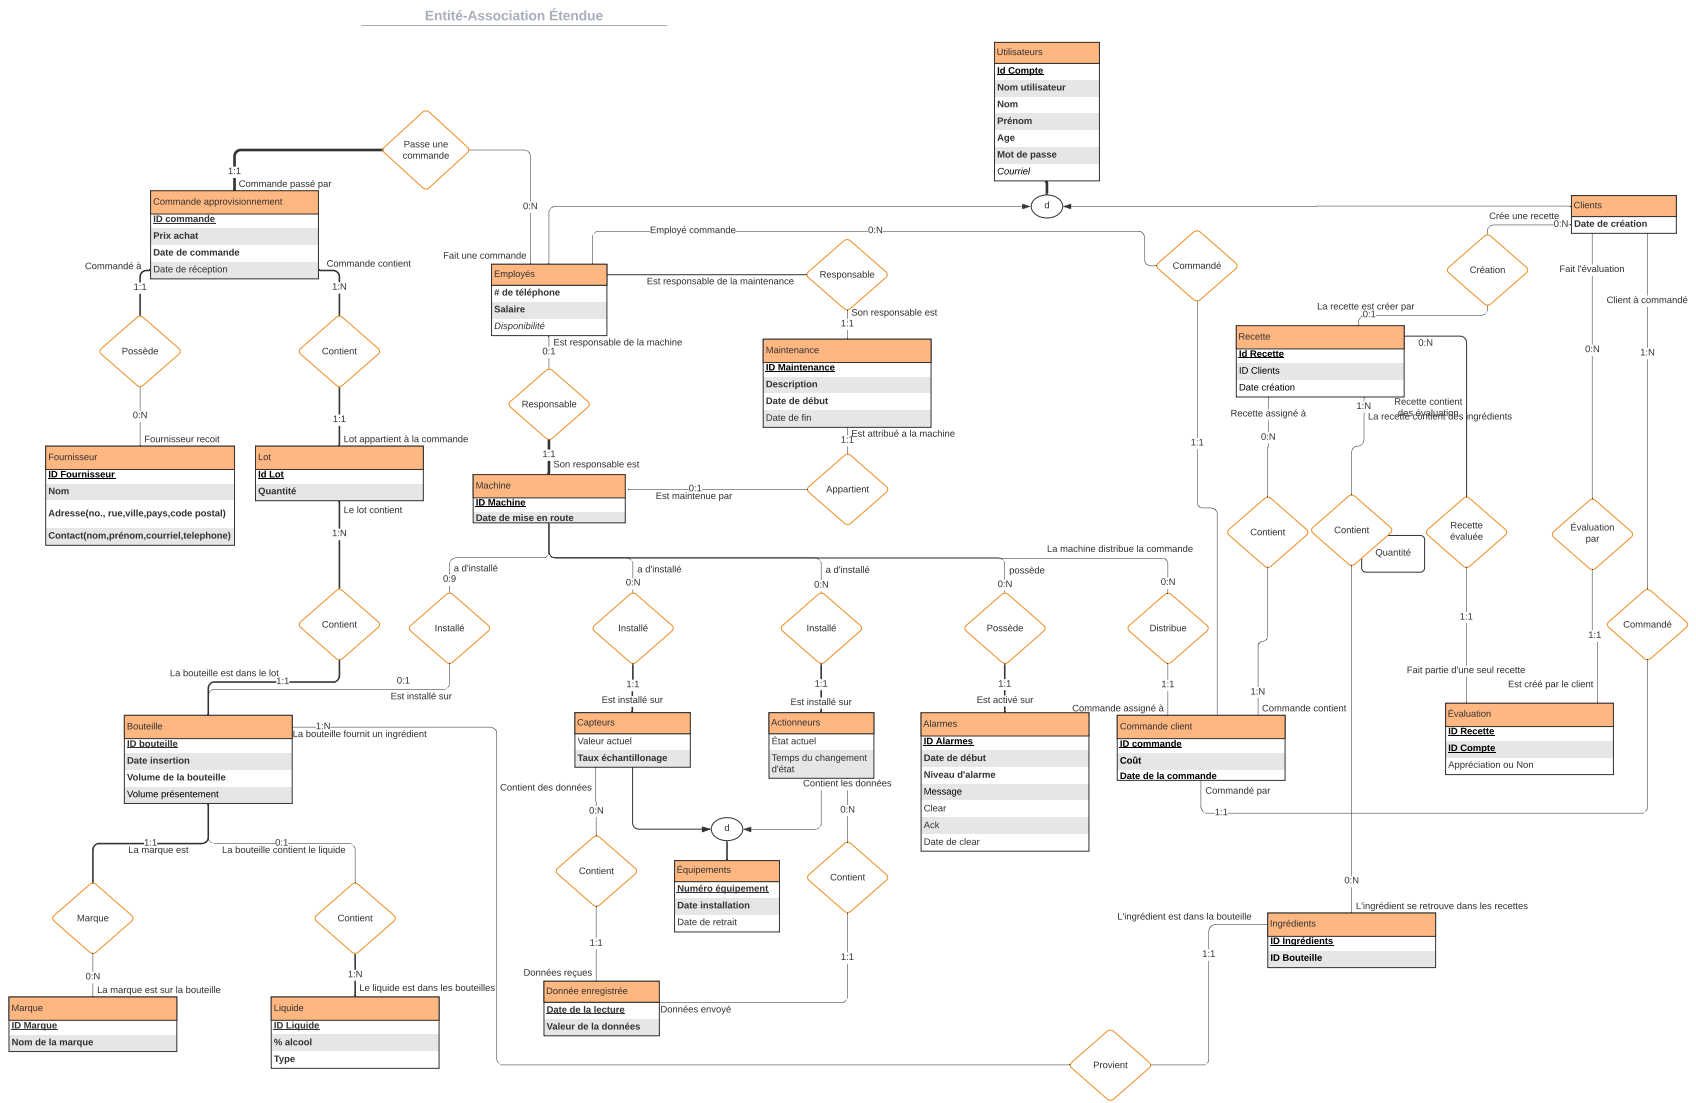
[picture p97: page 1]
Quantité; # de téléphone; Salaire; Disponibilité; Employés; Date de création; Clients; Id Recette; ID Clients; Date création; Recette; ID Liquide; % alcool; Type; Liquide; ID Fournisseur; Nom; Fournisseur; Id Lot; Lot; Valeur actuel; Taux échantillonage; Capteurs; Responsable; Commande contient; Commandé à; Fournisseur recoit; Contient; Possède; Passe une commande; Création; Installé; Distribue; Évaluation par; Fait l'évaluation; Marque; a d'installé; possède; Commande assigné à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

Utilisateurs
Id Compte
Nom utilisateur
Nom
Prénom
Age
Mot de passe
Courriel

Commande passé par

Commande approvisionnement
ID commande
Prix achat
Date de commande
Date de réception

Crée une recette

Fait une commande

Est responsable de la maintenance

Son responsable est

La recette est créer par

Est responsable de la machine

Maintenance
ID Maintenance
Description
Date de début
Date de fin

Recette contient
des évaluation
La recette contient des ingrédients

Lot appartient à la commande

Est attribué a la machine

Machine
ID Machine
Date de mise en route

Appartient Est maintenue par

Adresse(no., rue,ville,pays,code postal)

Le lot contient

Contact(nom,prénom,courriel,telephone)

La machine distribue la commande

La bouteille est dans le lot

Fait partie d'une seul recette

Est installé sur

Est activé sur

Est créé par le client

Évaluation
ID Recette
ID Compte
Appréciation ou Non

Bouteille
ID bouteille
Date insertion
Volume de la bouteille
Volume présentement

La bouteille fournit un ingrédient

Actionneurs
État actuel
Temps du changement
d'état
Contient les données

Alarmes
ID Alarmes
Niveau d'alarme
Message
Clear
Ack
Date de clear

Commande client
Coût
Date de la commande

Contient des données

La marque est

La bouteille contient le liquide

Équipements
Numéro équipement
Date installation
Date de retrait

L'ingrédient se retrouve dans les recettes

L'ingrédient est dans la bouteille

La marque est sur la bouteille

Le liquide est dans les bouteilles

Données reçues
Donnée enregistrée
Date de la lecture
Valeur de la données

Marque
ID Marque
Nom de la marque
