skyrimax/Autobar/Document Remise/Rapport final/Base donnée/Entité-Relationnel.pdf

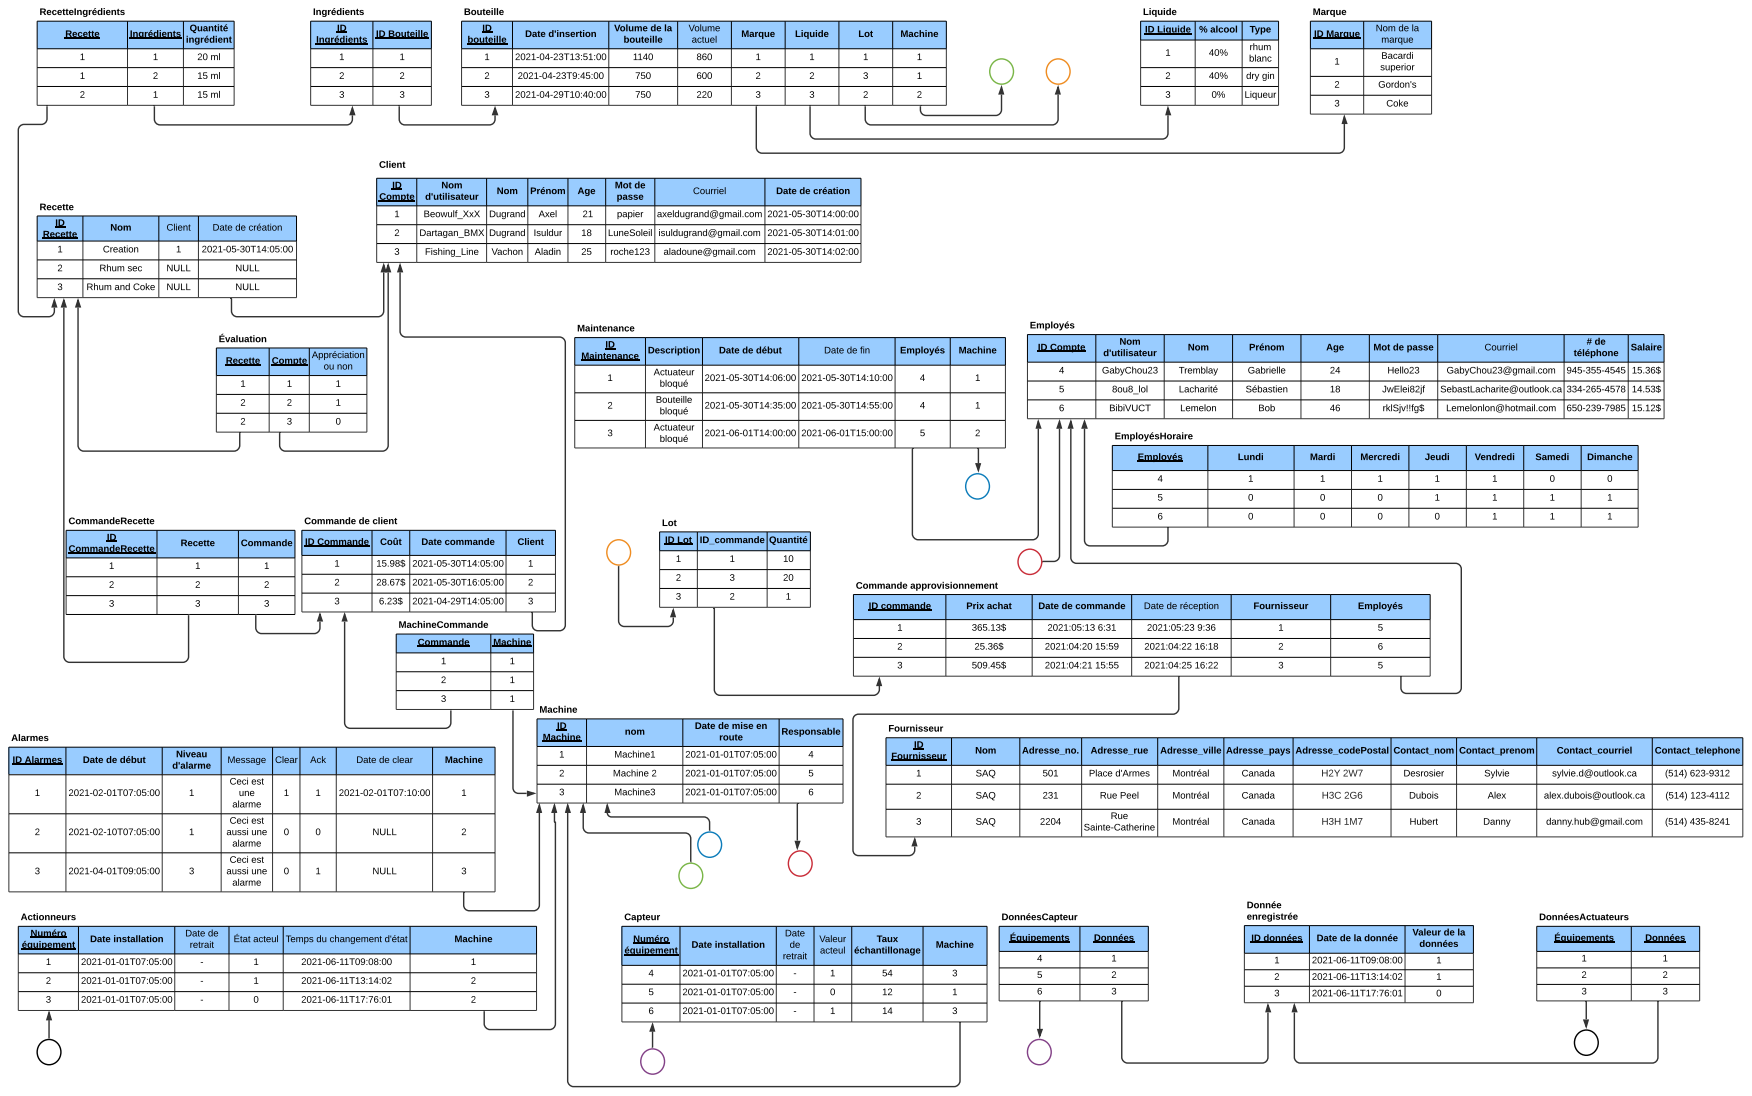
[picture p98: page 1]
Recette; Client; ID Compte; Nom d'utilisateur; Nom; Prénom; Age; Mot de passe; Courriel; Date de création; Évaluation; ID Commande; Coût; Date commande; Bouteille ID bouteille; Date d'insertion; Volume; actuel; Marque; Liquide; Lot; Machine; ID Marque; Bacardi; superior; ID Liquide; % alcool; Type; rhum blanc; dry gin; Liqueur; CommandeRecette; ID CommandeRecette; Commande; ID Lot; ID_commande; Quantité; Bouteille; bloqué; Actuateur; ID données; Date de la donnée; Numéro; équipement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

Volume de la
bouteille

Nom de la
marque

2 | Gordon's
3 | Coke

1 | Beowulf_XxX | Dugrand | Axel | 21 | papier | axeldugrand@gmail.com | 2021-05-30T14:00:00
2 | Dartagan_BMX | Dugrand | Isuldur | 18 | LuneSoleil | isuldugrand@gmail.com | 2021-05-30T14:01:00
3 | Fishing_Line | Vachon | Aladin | 25 | roche123 | aladoune@gmail.com | 2021-05-30T14:02:00

ID Recette | Nom | Client | Date de création

1 | Creation | 1 | 2021-05-30T14:05:00
2 | Rhum sec | NULL | NULL
3 | Rhum and Coke | NULL | NULL

Maintenance
ID Maintenance | Description | Date de début | Date de fin | Employés | Machine

Recette | Compte | Appréciation ou non

1 | Actuateur bloqué | 2021-05-30T14:06:00 | 2021-05-30T14:10:00 | 4 | 1

Commande de client

1 | 1 | 10
2 | 3 | 20

1 | 15.98$ | 2021-05-30T14:05:00 | 1
2 | 28.67$ | 2021-05-30T16:05:00 | 2
3 | 6.23$ | 2021-04-29T14:05:00 | 3

Date de mise en
route

Fournisseur
ID Fournisseur | Nom | Adresse_no. | Adresse_rue | Adresse_ville | Adresse_pays | Adresse_codePostal | Contact_nom | Contact_prenom | Contact_courriel | Contact_telephone

Alarmes
ID Alarmes | Date de début | Niveau d'alarme | Message | Clear | Ack | Date de clear | Machine

1 | SAQ | 501 | Place d'Armes | Montréal | Canada | H2Y 2W7 | Desrosier | Sylvie | sylvie.d@outlook.ca | (514) 623-9312

1 | 2021-02-01T07:05:00 | 1 | Ceci est une alarme | 1 | 1 | 2021-02-01T07:10:00 | 1

2 | SAQ | 231 | Rue Peel | Montréal | Canada | H3C 2G6 | Dubois | Alex | alex.dubois@outlook.ca | (514) 123-4112

2 | 2021-02-10T07:05:00 | 1 | Ceci est aussi une alarme | 0 | 0 | NULL | 2

3 | SAQ | 2204 | Rue Sainte-Catherine | Montréal | Canada | H3H 1M7 | Hubert | Danny | danny.hub@gmail.com | (514) 435-8241

3 | 2021-04-01T09:05:00 | 3 | Ceci est aussi une alarme | 0 | 1 | NULL | 3

Donnée enregistrée

Actionneurs

Numéro
équipement Date installation

Valeur de la
données

2 | 2021-01-01T07:05:00 | - | 1 | 2021-06-11T13:14:02 | 2
3 | 2021-01-01T07:05:00 | - | 0 | 2021-06-11T17:76:01 | 2

2 | 2021-06-11T13:14:02 | 1
3 | 2021-06-11T17:76:01 | 0
